fernandobeckman/ponte-de-palito-/docs/img/manual/p30.jpg

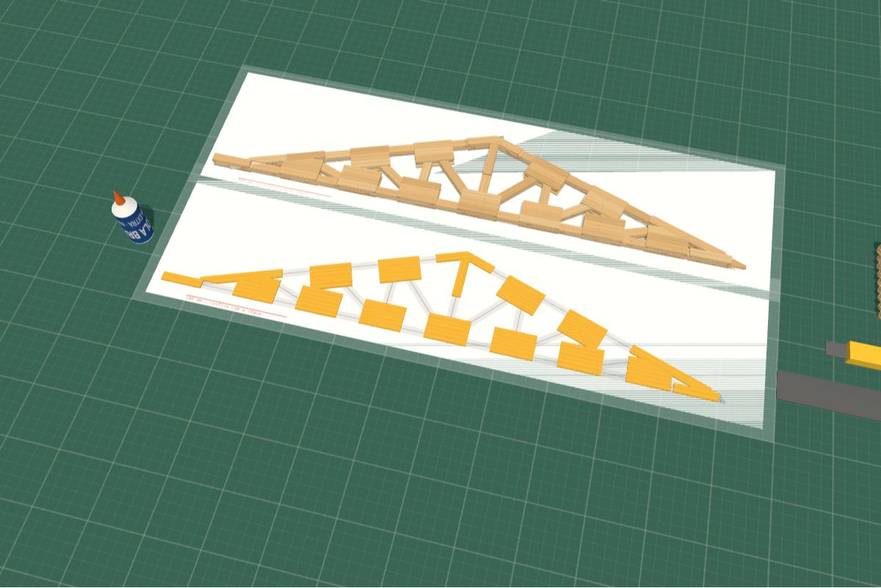
docs/img/manual/p30.jpg
