fernandobeckman/ponte-de-palito-/docs/img/manual/p22.jpg

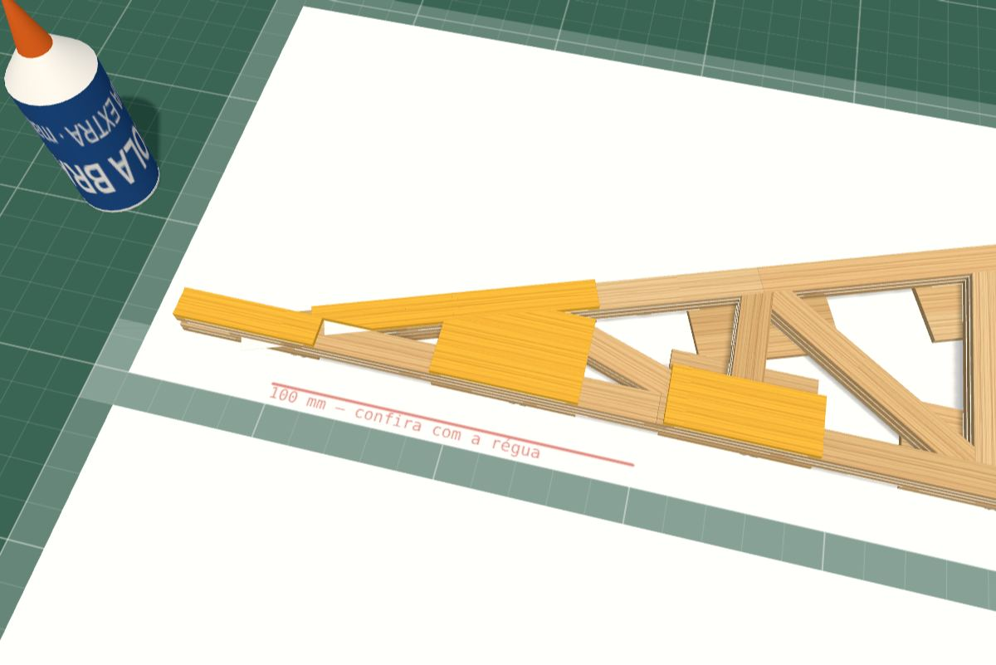
docs/img/manual/p22.jpg
