fernandobeckman/ponte-de-palito-/ERROS.md

# Registro de erros (ler antes de cada tarefa)

Erros já cometidos neste projeto, por Claude ou pela equipe, e a regra para não repeti-los.
Entradas novas vão **no topo**. Veja a skill `.claude/skills/registro-de-erros`.

| # | data | contexto | erro | causa | como evitar |
|---|---|---|---|---|---|
| 30 | 2026-11-09 | Publicação na Netlify | A Netlify recusou um novo deploy: "Account credit usage exceeded". O plano grátis tem créditos por mês, cada publicação gasta créditos, e a conta tem outros sites. Além disso, o script `publicar_netlify.sh` não mostrava o erro (imprimiu "None None") | Publiquei várias vezes seguidas, a cada ajuste pequeno, e o script engolia o erro | Juntar as mudanças e publicar na Netlify só no fim. O GitHub Pages continua como espelho, sem limite. O script agora para e mostra o erro da Netlify. |
| 29 | 2026-11-09 | Navegação 3D sem limites | A câmera podia passar para baixo da mesa (tela vazia, porque a mesa só aparece de cima) e se afastar até perder a cena. A vista "Baixo" levava para baixo da mesa | Dei liberdade total sem colocar barreiras | Toda cena 3D tem chão (câmera acima da mesa), caixa-limite para a câmera e para o ponto de foco, e distância máxima. Afastar o zoom não move o ponto de foco. |
| 28 | 2026-11-09 | Chave da Netlify | A primeira chave foi recusada (401, provavelmente copiada incompleta) e depois uma chave foi colada no chat | Não expliquei de início que a chave vai só no formulário seguro e que o código deve ser copiado pelo botão de copiar | Pedir chaves sempre pelo formulário seguro, nunca no chat. Se uma chave aparecer no chat, não usar e pedir para apagá-la e criar outra. |
| 27 | 2026-11-09 | Publicação no GitHub Pages | O campo "Domínio personalizado" foi preenchido com `fernando.beckman`. O GitHub criou `docs/CNAME` e passou a redirecionar para um domínio que não existe. Depois de remover, o celular continuou indo para o endereço antigo por cache | Nas instruções não avisei para deixar esse campo vazio | Ao orientar a ativação do Pages, avisar explicitamente: "Domínio personalizado fica vazio". Para testar depois de mudar o domínio, usar aba anônima. Conferir o status da publicação pela API de deployments (`environment_url`). |
| 26 | 2026-11-09 | Manual de corte | Primeira versão: (1) a folga visual de 0,3 mm entre peças entrava na medida de corte (99,7 mm em vez de 100 mm) e dividia peças iguais em códigos diferentes; (2) os ângulos saíam do contorno arredondado (19,0° em vez de 19,8°); (3) havia uma chapa triangular de 12,8 mm impossível de cortar | Efeito visual misturado com geometria real; arredondamento usado para medir, e não só para agrupar | Geometria de corte nunca leva folga visual. Arredondar só para agrupar tipos; medidas e ângulos saem da geometria exata e são conferidos com a inclinação conhecida (19,8°, 39,6°, 70,2°). Peças menores que 80 mm² são eliminadas. |
| 25 | 2026-11-09 | Navegação do 3D | O usuário achou o 3D "muito ruim para navegar": só girava, o zoom ia sempre para o centro, não havia pan e a câmera "Seguir o passo" puxava a vista de volta | Fiz um controle mínimo e liguei o seguir sem deixar o usuário no comando | Toda vista 3D precisa de: girar, mover (2 dedos ou botão direito), zoom na direção do dedo ou cursor, toque duplo para aproximar, modo para andar por dentro, vistas prontas e tela ampliada. Câmera automática desliga quando o usuário mexe. |
| 24 | 2026-11-09 | Espaçadores provisórios | Usei blocos genéricos ("madeira, caixinha, papelão"), mas o usuário definiu que a ponte é só palito de picolé e cola branca | Achei que peça provisória não precisava seguir a regra de material | Todo item que encosta na ponte, até o provisório, segue a regra de material do usuário. Agora os espaçadores são de palito (4 camadas × 2 palitos de 74 mm). Antes de propor qualquer peça, conferir em `docs/requisitos.md` ou no histórico. |
| 23 | 2026-11-09 | Espaçadores na animação | A legenda dizia 74 mm, mas o 3D desenhava blocos de 70 mm, encostados nas chapas e marrons como madeira. O usuário achou que faziam parte da ponte | Desenhei o bloco sem conferir com o texto, e peça provisória ficou parecendo peça definitiva | Peça provisória precisa de visual diferente (listrada, escrito "PROVISÓRIO") e de legenda dizendo que sai depois. A medida do 3D tem que ser a mesma do texto. |
| 22 | 2026-11-09 | 3D no celular (app do Claude, Android) | A montagem mostrou "Não foi possível carregar o 3D". O Three.js era carregado por *import map* (`import("three")`), e o OrbitControls também dependia dele. Causa provável: dentro do app a página é embrulhada pela plataforma, e navegadores Android mais antigos ignoram um *import map* que aparece depois de outro módulo já carregado | Testei só com a página sozinha, num Chromium recente, e não no ambiente real | Não usar *import map* em artifacts. Importar pelo endereço completo, com CDN de reserva (jsDelivr, depois unpkg), e usar controles próprios, sem módulos que importem `"three"`. Toda página 3D precisa ter modo texto caso o 3D falhe. Pedir ao usuário que teste no celular logo após publicar. |
| 21 | 2026-11-09 | Memorial v2 | Escrevi a resistência da diagonal central como 1296,13500 N; o valor calculado é 1296,10495 N | Digitei o número em vez de copiar da saída do script | Copiar todo número do memorial da saída de `calculo_ponte.py` (`projeto/saida_calculo.txt`), nunca digitar de memória. |
| 20 | 2026-11-09 | Página de montagem | O selo "24 h" e o texto "Carregando" apareciam o tempo todo: o `display: grid` do meu CSS anulava o atributo `hidden` | Contei com o reset da plataforma, que não existe no teste local | Todo CSS de página leva `[hidden] { display: none !important; }`. |
| 19 | 2026-11-09 | Chapas de ligação (v1) | Uma faixa de chapa (8,4 mm) cobria menos que os 13,42 mm de sobreposição exigidos pelo cálculo | O cálculo dizia "adote 20 mm", mas não conferi se a chapa desenhada tinha esse tamanho | Conferir cada dimensão do cálculo no modelo físico (`gerar_montagem.py`). Agora são 2 faixas, ou 16,8 mm. |
| 18 | 2026-11-09 | Transversina central (v1) | O memorial mandava apoiar a transversina "em cima do banzo inferior", mas ali passam o montante e duas diagonais do nó b4 | Detalhei a peça só no cálculo, sem desenhar a geometria | Detalhe construtivo só vale depois de modelado em 3D sem colisão. Agora ela fica sobre consolos. |
| 17 | 2026-11-09 | Camadas (v1) | Alma com 2 camadas (4 mm) e banzos com 3 (6 mm): as chapas das duas faces não ficariam planas | Dimensionei cada barra isoladamente, sem pensar na montagem | Barras que se encontram numa chapa precisam ter a mesma espessura. Agora todas têm 3 camadas. |
| 16 | 2026-11-09 | Pesquisa de preços e ficha técnica | `datasheets.tdx.henkel.com` foi bloqueado pela rede da sessão | Rede restrita | Usar o resumo da busca, citar a ficha técnica como fonte e marcar como estimativa o que não tiver preço publicado. |
| 15 | 2026-11-09 | Git | Fiz o commit sem verificar o resultado do `git checkout main`, que tinha falhado, e o commit caiu em outra branch. Também ficou um `.pyc` versionado | Encadeei comandos com `;` em vez de `&&`, e o repositório não tinha `.gitignore` | Encadear comandos git com `&&` e conferir `git status -sb` antes de cada commit. O `.gitignore` agora ignora `__pycache__`. |
| 14 | 2026-11-09 | Memorial: peso próprio | Escrevi "0,07% da carga"; o valor certo é 0,69% (0,309 kg ÷ 45 kg) | Fiz a porcentagem de cabeça | Toda porcentagem do memorial deve ser calculada no script ou conferida com a divisão escrita ao lado. |
| 13 | 2026-11-09 | Detalhamento das ligações | Calculei as chapas nó a nó para os banzos: 30 mm de sobreposição em cada ponta de barras de 62,5 mm, ou seja, chapa cobrindo quase a barra inteira | Dimensionei as ligações sem pensar em como a peça é montada | Verificar se a ligação cabe fisicamente. Banzos retos devem ser feitos contínuos e laminados, com emendas desencontradas. |
| 12 | 2026-11-09 | Estudo de geometrias | O primeiro estudo considerou só a carga exatamente no centro. Nele, o Parker tinha diagonais "nulas" com 2 camadas, mas com a carga deslocada um painel o FS caía para 1,21 | Hipótese de carregamento ideal demais | Dimensionar sempre por envoltória: carga no centro (FS 2,0) e deslocada ±1 painel (FS 1,5). |
| 11 | 2026-11-09 | Precisão numérica | O solver `trelica.py` arredondava N para 3 casas e L para 2, mas o usuário pediu 5 casas | Arredondamento fixo no código | O solver agora guarda 6 casas e imprime 5. Formatar na saída, nunca arredondar os dados internos. |
| 10 | 2026-11-09 | Pesquisa de material | Os sites periodicos.ufsm.br e blogspot estão bloqueados na rede da sessão | Rede restrita do ambiente | Se um host falhar com ENOTFOUND, não insistir em outros do mesmo tipo. Usar o resumo da busca, citar a fonte secundária e marcar [PENDENTE] para confirmação. |
| 9 | 2026-11-09 | Push de branch nova a partir de um clone raso | O push funcionou, mas `origin/<branch>` não apareceu no clone e o hook disse que havia commit não enviado | O clone raso (`--depth 1`) só busca a branch `main`, então o push não cria a referência remota local | Depois de enviar uma branch nova, rodar `git fetch origin +refs/heads/<branch>:refs/remotes/origin/<branch>` e conferir com `git status -sb`. |
| 8 | 2026-11-09 | Teste da página 3D no Chromium headless | O Three.js do CDN (unpkg) não carregou (`ERR_TUNNEL_CONNECTION_FAILED`) | O Chromium da sessão na nuvem não passa pelo proxy para CDNs | Para testar, instalar a mesma versão com `npm i three@0.160.0` e interceptar as URLs do CDN com `page.route` para os arquivos locais. Fixar sempre a versão exata. |
| 7 | 2026-11-09 | Skill `openscad-ponte` (json2scad.py) | Rotação das barras escrita com sinais negativos: `rotate([0,-acos(..),-atan2(..)])`, o que apontaria as barras na direção errada | Escrevi a fórmula de memória sem conferir | Conferir toda transformação geométrica numericamente: o vetor (0,0,1) rotacionado tem de bater com d/L. A forma correta é `rotate([0, acos(dz/L), atan2(dy,dx)])`. |
| 6 | 2026-11-09 | Seleção de skills | Quase incluí `doc-coauthoring` (Anthropic) e a skill OpenSCAD de andreahaku, mas elas **não têm arquivo de licença** | Supus que repositório público = livre para copiar | Antes de copiar, verificar o arquivo LICENSE de **cada** skill/agente. Sem licença → só citar como referência, não copiar. |
| 5 | 2026-11-09 | Agentes da VoltAgent | 3 agentes (`scientific-literature-researcher`, `ui-ux-tester`, `visual-asset-generator`) citam ferramentas MCP que não estão instaladas | Os agentes vieram de outro ambiente | Antes de usar um agente, ver a linha `tools:`. Se citar `mcp__...` ou `chrome-mcp`, instalar o MCP ou esperar só funcionamento parcial. |
| 4 | 2026-11-09 | Shell | Usei `cd` para dentro de pastas e o diretório de trabalho da sessão mudou junto | O `cd` persiste entre os comandos | Usar sempre caminhos absolutos nos comandos e não depender de `cd`. |
| 3 | 2026-11-09 | Ver estrelas de repositórios | `curl api.github.com/repos/...` foi bloqueado para repositórios não anexados à sessão | O proxy só libera a API do GitHub para repositórios anexados | Para metadados públicos (estrelas e licença), usar WebFetch na página do GitHub. Para o código, usar `git clone --depth 1`. |
| 2 | 2026-11-09 | Criar um repositório no GitHub | `gh auth status` mostrou que o token `GH_TOKEN` é inválido, então não dá para criar repositório pelo `gh` | A sessão na nuvem não tem um token pessoal válido | Criar repositório só pelo site (github.com/new). Para anexar um repositório que já existe, usar a ferramenta `add_repo`. |
| 1 | 2026-11-09 | Cálculo da treliça | (prevenção) Um resultado de solver pode estar errado sem dar nenhum aviso | — | Sempre conferir o equilíbrio (deve dar ≈0) e checar uma barra à mão pelo método das seções antes de reportar. |
