fernandobeckman/ponte-de-palito-/docs/img/capa.jpg

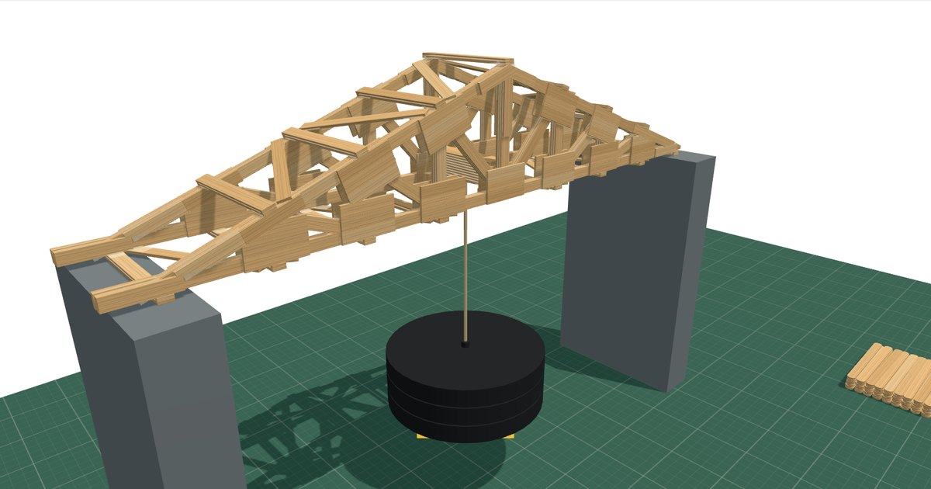
docs/img/capa.jpg
