fernandobeckman/ponte-de-palito-/docs/img/passo_corte.jpg

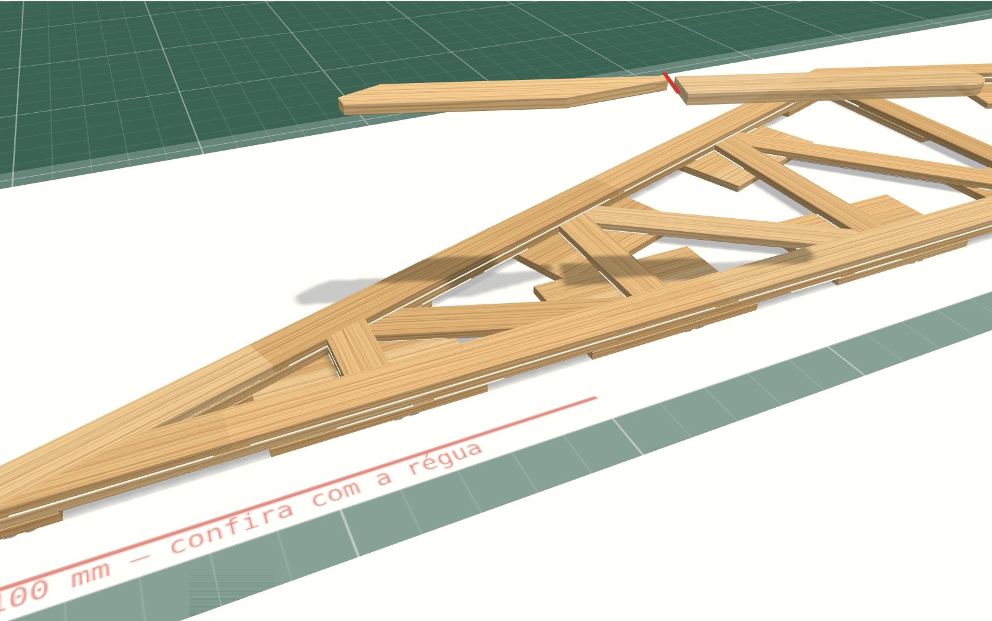
docs/img/passo_corte.jpg
