fernandobeckman/ponte-de-palito-/docs/img/passo_levantar.jpg

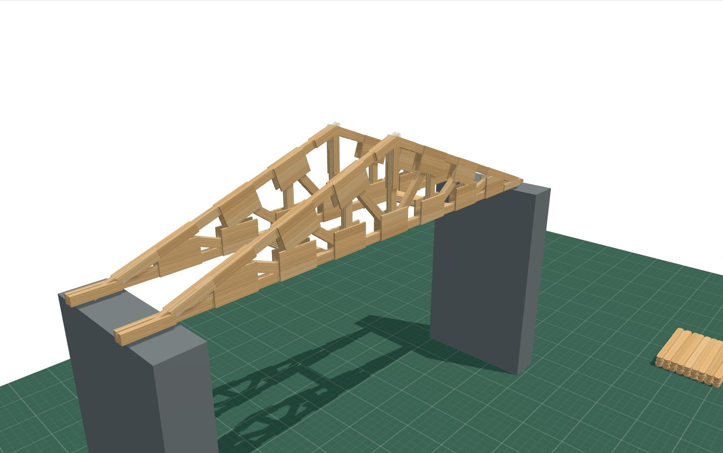
docs/img/passo_levantar.jpg
