fernandobeckman/ponte-de-palito-/docs/img/passo_trelica.jpg

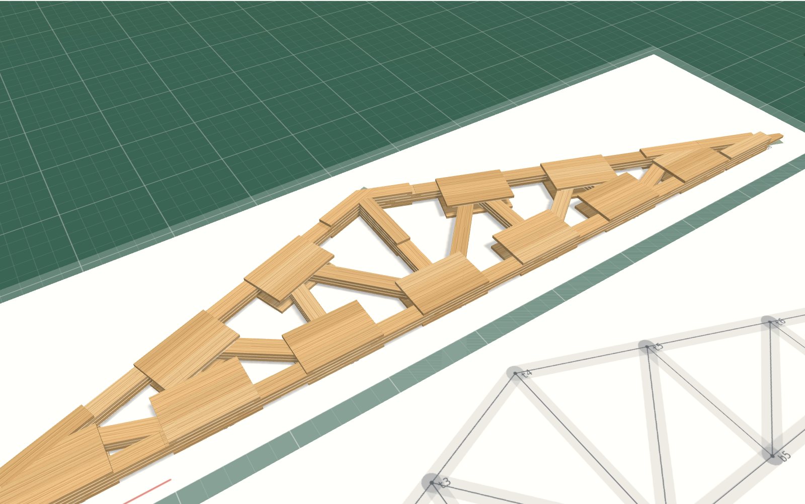
docs/img/passo_trelica.jpg
