fernandobeckman/ponte-de-palito-/docs/img/por_dentro.jpg

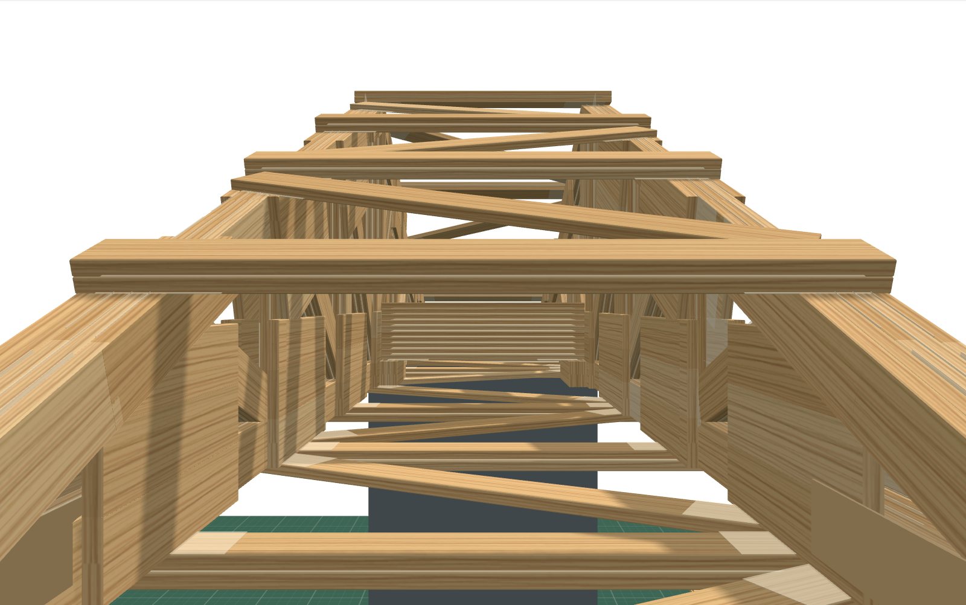
docs/img/por_dentro.jpg
