fernandobeckman/ponte-de-palito-/projeto/ponte-3d.png

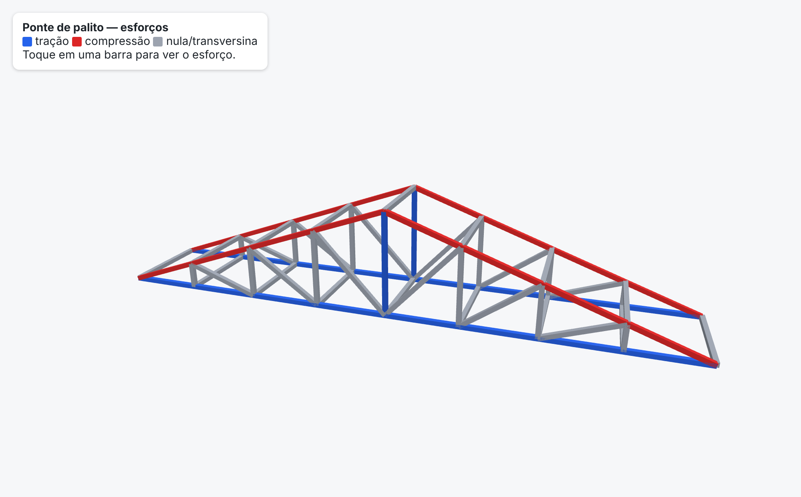
projeto/ponte-3d.png
