fernandobeckman/ponte-de-palito-/modelos/ponte_parker_8x90.scad

// gerado por json2scad.py — seção 8.4 x 4.0 mm
b=8.4; h=4.0;
module barra(p1,p2){ d=p2-p1; L=norm(d);
  translate(p1) rotate([0,acos(d[2]/L),atan2(d[1],d[0])])
  translate([-b/2,-h/2,0]) cube([b,h,L]); }
barra([0.0, 0.0, 0.0],[62.5, 0.0, 0.0]);
barra([62.5, 0.0, 0.0],[125.0, 0.0, 0.0]);
barra([125.0, 0.0, 0.0],[187.5, 0.0, 0.0]);
barra([187.5, 0.0, 0.0],[250.0, 0.0, 0.0]);
barra([250.0, 0.0, 0.0],[312.5, 0.0, 0.0]);
barra([312.5, 0.0, 0.0],[375.0, 0.0, 0.0]);
barra([375.0, 0.0, 0.0],[437.5, 0.0, 0.0]);
barra([437.5, 0.0, 0.0],[500.0, 0.0, 0.0]);
barra([62.5, 22.5, 0.0],[125.0, 45.0, 0.0]);
barra([125.0, 45.0, 0.0],[187.5, 67.5, 0.0]);
barra([187.5, 67.5, 0.0],[250.0, 90.0, 0.0]);
barra([250.0, 90.0, 0.0],[312.5, 67.5, 0.0]);
barra([312.5, 67.5, 0.0],[375.0, 45.0, 0.0]);
barra([375.0, 45.0, 0.0],[437.5, 22.5, 0.0]);
barra([0.0, 0.0, 0.0],[62.5, 22.5, 0.0]);
barra([437.5, 22.5, 0.0],[500.0, 0.0, 0.0]);
barra([62.5, 0.0, 0.0],[62.5, 22.5, 0.0]);
barra([125.0, 0.0, 0.0],[125.0, 45.0, 0.0]);
barra([187.5, 0.0, 0.0],[187.5, 67.5, 0.0]);
barra([250.0, 0.0, 0.0],[250.0, 90.0, 0.0]);
barra([312.5, 0.0, 0.0],[312.5, 67.5, 0.0]);
barra([375.0, 0.0, 0.0],[375.0, 45.0, 0.0]);
barra([437.5, 0.0, 0.0],[437.5, 22.5, 0.0]);
barra([62.5, 22.5, 0.0],[125.0, 0.0, 0.0]);
barra([125.0, 45.0, 0.0],[187.5, 0.0, 0.0]);
barra([187.5, 67.5, 0.0],[250.0, 0.0, 0.0]);
barra([312.5, 67.5, 0.0],[250.0, 0.0, 0.0]);
barra([375.0, 45.0, 0.0],[312.5, 0.0, 0.0]);
barra([437.5, 22.5, 0.0],[375.0, 0.0, 0.0]);
barra([0.0, 0.0, 80.0],[62.5, 0.0, 80.0]);
barra([62.5, 0.0, 80.0],[125.0, 0.0, 80.0]);
barra([125.0, 0.0, 80.0],[187.5, 0.0, 80.0]);
barra([187.5, 0.0, 80.0],[250.0, 0.0, 80.0]);
barra([250.0, 0.0, 80.0],[312.5, 0.0, 80.0]);
barra([312.5, 0.0, 80.0],[375.0, 0.0, 80.0]);
barra([375.0, 0.0, 80.0],[437.5, 0.0, 80.0]);
barra([437.5, 0.0, 80.0],[500.0, 0.0, 80.0]);
barra([62.5, 22.5, 80.0],[125.0, 45.0, 80.0]);
barra([125.0, 45.0, 80.0],[187.5, 67.5, 80.0]);
barra([187.5, 67.5, 80.0],[250.0, 90.0, 80.0]);
barra([250.0, 90.0, 80.0],[312.5, 67.5, 80.0]);
barra([312.5, 67.5, 80.0],[375.0, 45.0, 80.0]);
barra([375.0, 45.0, 80.0],[437.5, 22.5, 80.0]);
barra([0.0, 0.0, 80.0],[62.5, 22.5, 80.0]);
barra([437.5, 22.5, 80.0],[500.0, 0.0, 80.0]);
barra([62.5, 0.0, 80.0],[62.5, 22.5, 80.0]);
barra([125.0, 0.0, 80.0],[125.0, 45.0, 80.0]);
barra([187.5, 0.0, 80.0],[187.5, 67.5, 80.0]);
barra([250.0, 0.0, 80.0],[250.0, 90.0, 80.0]);
barra([312.5, 0.0, 80.0],[312.5, 67.5, 80.0]);
barra([375.0, 0.0, 80.0],[375.0, 45.0, 80.0]);
barra([437.5, 0.0, 80.0],[437.5, 22.5, 80.0]);
barra([62.5, 22.5, 80.0],[125.0, 0.0, 80.0]);
barra([125.0, 45.0, 80.0],[187.5, 0.0, 80.0]);
barra([187.5, 67.5, 80.0],[250.0, 0.0, 80.0]);
barra([312.5, 67.5, 80.0],[250.0, 0.0, 80.0]);
barra([375.0, 45.0, 80.0],[312.5, 0.0, 80.0]);
barra([437.5, 22.5, 80.0],[375.0, 0.0, 80.0]);
barra([0.0, 0.0, 0.0],[0.0, 0.0, 80.0]);
barra([62.5, 0.0, 0.0],[62.5, 0.0, 80.0]);
barra([125.0, 0.0, 0.0],[125.0, 0.0, 80.0]);
barra([187.5, 0.0, 0.0],[187.5, 0.0, 80.0]);
barra([250.0, 0.0, 0.0],[250.0, 0.0, 80.0]);
barra([312.5, 0.0, 0.0],[312.5, 0.0, 80.0]);
barra([375.0, 0.0, 0.0],[375.0, 0.0, 80.0]);
barra([437.5, 0.0, 0.0],[437.5, 0.0, 80.0]);
barra([500.0, 0.0, 0.0],[500.0, 0.0, 80.0]);
barra([62.5, 22.5, 0.0],[62.5, 22.5, 80.0]);
barra([125.0, 45.0, 0.0],[125.0, 45.0, 80.0]);
barra([187.5, 67.5, 0.0],[187.5, 67.5, 80.0]);
barra([250.0, 90.0, 0.0],[250.0, 90.0, 80.0]);
barra([312.5, 67.5, 0.0],[312.5, 67.5, 80.0]);
barra([375.0, 45.0, 0.0],[375.0, 45.0, 80.0]);
barra([437.5, 22.5, 0.0],[437.5, 22.5, 80.0]);
