fernandobeckman/ponte-de-palito-/docs/manual_de_corte.pdf

Manual de corte — como usar | Ponte Parker 8×90 · manual de corte · página 1

### Cada formato de peça tem um CÓDIGO

letra da família + número (ex.: B1 = banzo de 100 mm com cortes retos).

### Cada peça da ponte tem um NÚMERO

### de 1 a 412, na ordem de montagem. Escreva o número a lápis na peça logo depois de

cortar.
Moldes em tamanho real | imprima em 100% (sem ajustar à página) e confira a régua de 100 mm. Apoie o palito
sobre o molde e corte nas linhas.
Ângulo do corte | medido entre a linha de corte e a borda comprida do palito. 90° = corte reto. 'Em bico' =
ponta com dois cortes.
Borda A e borda B | comprimento de cada lado comprido depois de cortado. Marque as duas medidas e
ligue os pontos com a régua.
Palito | 8,4 mm × 2,0 mm × 110 mm; parte reta útil de 101,6 mm (sem as pontas
arredondadas).
Peças iguais | têm o mesmo código: corte todas de uma vez, separe em montinhos por código (como
os saquinhos do LEGO).

## Famílias de peças

B Banzo | 16 tipo(s), 80 peça(s)
D Diagonal | 3 tipo(s), 36 peça(s)
M Montante | 4 tipo(s), 42 peça(s)
C Chapa de ligação | 8 tipo(s), 168 peça(s)
T Transversina | 2 tipo(s), 36 peça(s)
E Escora superior | 1 tipo(s), 14 peça(s)
X Diagonal de contraventamento | 1 tipo(s), 14 peça(s)
K Consolo | 1 tipo(s), 6 peça(s)
P Espaçador provisório | 1 tipo(s), 16 peça(s) — provisório, não fica na ponte

Total: 412 peças em 37 tipos. Dica: corte primeiro os tipos com mais peças (C6, B1, T2...).

Régua de conferência: esta linha deve medir exatamente 100 mm. Se não medir, imprima em 100% (tamanho real).

Moldes em tamanho real (1:1) | Ponte Parker 8×90 · manual de corte · página 2

B1 × 44

Banzo · comprimento total 100,0 mm
Borda A 100,0 mm · borda B 100,0 mm
Pontas: reta (90°) | reta (90°)
Nº 43, 45–47, 50–52, 70–71, 73, 76–79, 97–100, 102, 104–106, 206, 208–210, 213–215, …

B1

100,0 mm

B2 × 4

Banzo · comprimento total 99,3 mm Borda A 99,3 mm · borda B 75,9 mm
Pontas: reta (90°) | inclinada a 19,8°
Nº 44, 53, 207, 216

B2

99,3 mm

B3 × 2

Banzo · comprimento total 96,7 mm Borda A 96,7 mm · borda B 96,7 mm
Pontas: reta (90°) | reta (90°)
Nº 107, 270

B3

96,7 mm

B4 × 2

Banzo · comprimento total 92,0 mm Borda A 92,0 mm · borda B 92,0 mm
Pontas: reta (90°) | reta (90°)
Nº 72, 235

B4

92,0 mm

B5 × 2

Banzo · comprimento total 77,4 mm Borda A 77,4 mm · borda B 67,2 mm
Pontas: reta (90°) | inclinada a 39,6°
Nº 48, 211

B5

77,4 mm

B6 × 4

Banzo · comprimento total 64,3 mm Borda A 63,2 mm · borda B 49,5 mm
Pontas: reta (90°) | em bico: 70,2° e 19,8°
Nº 68, 81, 231, 244

B6

64,3 mm

B7 × 2

Banzo · comprimento total 64,2 mm Borda A 64,2 mm · borda B 54,0 mm
Pontas: reta (90°) | inclinada a 39,6°
Nº 49, 212

B7

64,2 mm

B8 × 2

Banzo · comprimento total 62,6 mm Borda A 62,6 mm · borda B 39,3 mm
Pontas: reta (90°) | inclinada a 19,8°
Nº 80, 243

B8

62,6 mm

B9 × 2

Banzo · comprimento total 44,0 mm Borda A 44,0 mm · borda B 33,9 mm
Pontas: reta (90°) | inclinada a 39,6°
Nº 101, 264

B9

44,0 mm

Régua de conferência: esta linha deve medir exatamente 100 mm. Se não medir, imprima em 100% (tamanho real).

Moldes em tamanho real (1:1) | Ponte Parker 8×90 · manual de corte · página 3

B10 × 2

Banzo · comprimento total 35,9 mm
Borda A 35,9 mm · borda B 12,6 mm
Pontas: reta (90°) | inclinada a 19,8°
Nº 69, 232

B10

35,9 mm

B11 × 2

Banzo · comprimento total 33,3 mm Borda A 33,3 mm · borda B 33,3 mm
Pontas: reta (90°) | reta (90°)
Nº 95, 258

B11

33,3 mm

B12 × 4

Banzo · comprimento total 32,6 mm Borda A 32,6 mm · borda B 9,3 mm
Pontas: reta (90°) | inclinada a 19,8°
Nº 96, 108, 259, 271

B12

32,6 mm

B13 × 2

Banzo · comprimento total 30,9 mm Borda A 30,9 mm · borda B 20,7 mm
Pontas: reta (90°) | inclinada a 39,6°
Nº 103, 266

B13

30,9 mm

B14 × 2

Banzo · comprimento total 30,0 mm Borda A 30,0 mm · borda B 30,0 mm
Pontas: reta (90°) | reta (90°)
Nº 54, 217

B14

30,0 mm

B15 × 2

Banzo · comprimento total 28,6 mm Borda A 28,6 mm · borda B 18,5 mm
Pontas: reta (90°) | inclinada a 39,6°
Nº 75, 238

B15

28,6 mm

B16 × 2

Banzo · comprimento total 23,5 mm Borda A 23,5 mm · borda B 13,3 mm
Pontas: reta (90°) | inclinada a 39,6°
Nº 74, 237

B16

23,5 mm

D1 × 12

Diagonal · comprimento total 81,0 mm
Borda A 74,9 mm · borda B 71,7 mm
Pontas: em bico: 67,0° e 42,8° | em bico: 47,2° e 42,8°
Nº 60, 62, 87, 89, 114, 116, 223, 225, 250, 252, 277, 279

D1

81,0 mm

D2 × 12

Diagonal · comprimento total 66,0 mm
Borda A 60,8 mm · borda B 55,8 mm
Pontas: em bico: 55,6° e 54,2° | em bico: 35,8° e 54,2°
Nº 58, 64, 85, 91, 112, 118, 221, 227, 248, 254, 275, 281

D2

66,0 mm

Moldes em tamanho real (1:1) | Ponte Parker 8×90 · manual de corte · página 4

D3 × 12

Diagonal · comprimento total 56,1 mm
Borda A 48,8 mm · borda B 36,4 mm
Pontas: em bico: 39,6° e 70,2° | em bico: 19,8° e 70,2°
Nº 56, 66, 83, 93, 110, 120, 219, 229, 246, 256, 273, 283

D3

56,1 mm

M1 × 6

Montante · comprimento total 81,3 mm Borda A 79,8 mm · borda B 79,8 mm
Pontas: reta (90°) | em bico: 70,2° e 70,2°
Nº 61, 88, 115, 224, 251, 278

M1

81,3 mm

M2 × 12

Montante · comprimento total 60,3 mm
Borda A 60,3 mm · borda B 57,3 mm
Pontas: reta (90°) | inclinada a 70,2°
Nº 59, 63, 86, 90, 113, 117, 222, 226, 249, 253, 276, 280

M2

60,3 mm

M3 × 12

Montante · comprimento total 37,8 mm
Borda A 37,8 mm · borda B 34,8 mm
Pontas: reta (90°) | inclinada a 70,2°
Nº 57, 65, 84, 92, 111, 119, 220, 228, 247, 255, 274, 282

M3

37,8 mm

M4 × 12

Montante · comprimento total 15,3 mm
Borda A 15,3 mm · borda B 12,3 mm
Pontas: reta (90°) | inclinada a 70,2°
Nº 55, 67, 82, 94, 109, 121, 218, 230, 245, 257, 272, 284

M4

15,3 mm

C1 × 4

Chapa de ligação · comprimento total 41,7 mm Borda A 41,7 mm · borda B 31,5 mm
Pontas: reta (90°) | inclinada a 39,6°
Nº 19, 140, 182, 303

C1

41,7 mm

C2 × 4

Chapa de ligação · comprimento total 41,5 mm Borda A 40,0 mm · borda B 40,0 mm
Pontas: reta (90°) | em bico: 70,2° e 70,2°
Nº 23, 144, 186, 307

C2

41,5 mm

C3 × 8

Chapa de ligação · comprimento total 40,0 mm Borda A 40,0 mm · borda B 23,9 mm
Pontas: reta (90°) | em bico: 90,0° e 19,8°
Nº 2, 41, 123, 162, 165, 204, 286, 325

C3

40,0 mm

C4 × 8

Chapa de ligação · comprimento total 40,0 mm Borda A 40,0 mm · borda B 32,5 mm
Pontas: reta (90°) | em bico: 90,0° e 19,8°
Nº 12, 31, 133, 152, 175, 194, 296, 315

C4

40,0 mm

Moldes em tamanho real (1:1) | Ponte Parker 8×90 · manual de corte · página 5

C5 × 8

Chapa de ligação · comprimento total 40,0 mm
Borda A 40,0 mm · borda B 35,1 mm
Pontas: reta (90°) | em bico: 19,8° e 90,0°
Nº 3, 40, 124, 161, 166, 203, 287, 324

C5

40,0 mm

C6 × 124

Chapa de ligação · comprimento total 40,0 mm
Borda A 40,0 mm · borda B 40,0 mm
Pontas: reta (90°) | reta (90°)
Nº 1, 4–5, 7–11, 13–18, 20–22, 25–30, 32–36, 38–39, 42, 122, 125–126, 128–132, 134–1…

C6

40,0 mm

C7 × 8

Chapa de ligação · comprimento total 35,1 mm Borda A 35,1 mm · borda B 11,8 mm
Pontas: reta (90°) | inclinada a 19,8°
Nº 6, 37, 127, 158, 169, 200, 290, 321

C7

35,1 mm

C8 × 4

Chapa de ligação · comprimento total 28,5 mm Borda A 28,5 mm · borda B 18,3 mm
Pontas: reta (90°) | inclinada a 39,6°
Nº 24, 145, 187, 308

C8

28,5 mm

T1 × 16

Transversina · comprimento total 90,0 mm Borda A 90,0 mm · borda B 90,0 mm
Pontas: reta (90°) | reta (90°)
Nº 343–358

T1

90,0 mm

T2 × 20

Transversina · comprimento total 70,0 mm Borda A 70,0 mm · borda B 70,0 mm
Pontas: reta (90°) | reta (90°)
Nº 393–412

T2

70,0 mm

E1 × 14

Escora superior · comprimento total 90,0 mm Borda A 90,0 mm · borda B 90,0 mm
Pontas: reta (90°) | reta (90°)
Nº 367–380

E1

90,0 mm

X1 × 14

Diagonal de contraventamento · comprimento total 96,6 mm Borda A 96,6 mm · borda B 96,6 mm
Pontas: reta (90°) | reta (90°)
Nº 359–366, 381–386

X1

96,6 mm

K1 × 6

Consolo · comprimento total 30,0 mm Borda A 30,0 mm · borda B 30,0 mm
Pontas: reta (90°) | reta (90°)
Nº 387–392

K1

30,0 mm

Moldes em tamanho real (1:1) | Ponte Parker 8×90 · manual de corte · página 6

P1 × 16

Espaçador provisório · comprimento total 74,0 mm
Borda A 74,0 mm · borda B 74,0 mm
Pontas: reta (90°) | reta (90°)
Nº 327–342

P1

74,0 mm

Índice numerado: número da peça → código | Ponte Parker 8×90 · manual de corte · página 7

Treliça A · chapas da face de baixo

### 1 C6 2 C3 3 C5 4 C6 5 C6 6 C7 7 C6 8 C6 9 C6

### 10 C6 11 C6 12 C4 13 C6 14 C6 15 C6 16 C6 17 C6 18 C6 19 C1 20 C6 21 C6 22 C6 23 C2 24 C8 25 C6 26 C6 27 C6 28 C6 29 C6 30 C6 31 C4 32 C6 33 C6 34 C6 35 C6 36 C6 37 C7 38 C6 39 C6 40 C5 41 C3 42 C6

Treliça A · camada 1

### 43 B1 44 B2 45 B1 46 B1 47 B1 48 B5 49 B7 50 B1 51 B1 52 B1 53 B2

### 54 B14

### 55 M4 56 D3 57 M3 58 D2 59 M2 60 D1 61 M1 62 D1 63 M2 64 D2 65 M3 66 D3 67 M4

Treliça A · camada 2

### 68 B6

### 69 B10

### 70 B1 71 B1 72 B4 73 B1

### 74 B16 75 B15

### 76 B1 77 B1 78 B1 79 B1 80 B8 81 B6 82 M4 83 D3 84 M3 85 D2 86 M2 87 D1 88 M1 89 D1 90 M2 91 D2 92 M3 93 D3 94 M4

Treliça A · camada 3

### 95 B11 96 B12

### 97 B1 98 B1 99 B1

100 B1
101 B9
102 B1
103 B13
104 B1
105 B1
106 B1
107 B3
108 B12
109 M4
110 D3
111 M3
112 D2
113 M2
114 D1
115 M1
116 D1
117 M2
118 D2
119 M3
120 D3
121 M4
Treliça A · chapas da face de cima 122 C6
123 C3
124 C5
125 C6
126 C6
127 C7
128 C6
129 C6
130 C6
131 C6
132 C6
133 C4
134 C6
135 C6
136 C6
137 C6
138 C6
139 C6
140 C1
141 C6
142 C6
143 C6
144 C2
145 C8
146 C6
147 C6
148 C6
149 C6
150 C6
151 C6

152 C4
153 C6
154 C6
155 C6
156 C6
157 C6
158 C7
159 C6
160 C6
161 C5
162 C3
163 C6
Treliça B · chapas da face de baixo 164 C6
165 C3
166 C5
167 C6
168 C6
169 C7
170 C6
171 C6
172 C6
173 C6
174 C6
175 C4
176 C6
177 C6
178 C6
179 C6
180 C6
181 C6
182 C1
183 C6
184 C6
185 C6
186 C2
187 C8
188 C6
189 C6
190 C6
191 C6
192 C6
193 C6
194 C4
195 C6
196 C6
197 C6
198 C6
199 C6
200 C7
201 C6
202 C6
203 C5
204 C3
205 C6
Treliça B · camada 1
206 B1
207 B2
208 B1
209 B1
210 B1
211 B5
212 B7
213 B1
214 B1
215 B1
216 B2
217 B14
218 M4
219 D3
220 M3
221 D2
222 M2
223 D1
224 M1
225 D1
226 M2
227 D2

228 M3
229 D3
230 M4
Treliça B · camada 2
231 B6
232 B10
233 B1
234 B1
235 B4
236 B1
237 B16
238 B15
239 B1
240 B1
241 B1
242 B1
243 B8
244 B6
245 M4
246 D3
247 M3
248 D2
249 M2
250 D1
251 M1
252 D1
253 M2
254 D2
255 M3
256 D3
257 M4
Treliça B · camada 3
258 B11
259 B12
260 B1
261 B1
262 B1
263 B1
264 B9
265 B1
266 B13
267 B1
268 B1
269 B1
270 B3
271 B12
272 M4
273 D3
274 M3
275 D2
276 M2
277 D1
278 M1
279 D1
280 M2
281 D2
282 M3
283 D3
284 M4
Treliça B · chapas da face de cima 285 C6
286 C3
287 C5
288 C6
289 C6
290 C7
291 C6
292 C6
293 C6
294 C6
295 C6
296 C4
297 C6
298 C6
299 C6
300 C6
301 C6
302 C6

Índice numerado (continuação) | Ponte Parker 8×90 · manual de corte · página 8

303 C1
304 C6
305 C6
306 C6
307 C2
308 C8
309 C6
310 C6
311 C6
312 C6
313 C6
314 C6
315 C4
316 C6
317 C6
318 C6
319 C6
320 C6
321 C7
322 C6
323 C6
324 C5
325 C3
326 C6
Espaçadores provisórios
327 P1
328 P1
329 P1
330 P1
331 P1
332 P1
333 P1
334 P1
335 P1
336 P1
337 P1
338 P1
339 P1
340 P1
341 P1
342 P1
Transversinas inferiores
343 T1
344 T1
345 T1
346 T1
347 T1
348 T1
349 T1
350 T1
351 T1
352 T1
353 T1
354 T1
355 T1
356 T1
357 T1
358 T1
Contraventamento inferior
359 X1
360 X1
361 X1
362 X1
363 X1
364 X1
365 X1
366 X1
Escoras superiores
367 E1
368 E1
369 E1
370 E1
371 E1
372 E1
373 E1
374 E1
375 E1
376 E1

377 E1
378 E1
379 E1
380 E1
Contraventamento superior
381 X1
382 X1
383 X1
384 X1
385 X1
386 X1
Transversina central
387 K1
388 K1
389 K1
390 K1
391 K1
392 K1
393 T2
394 T2
395 T2
396 T2
397 T2
398 T2
399 T2
400 T2
401 T2
402 T2
403 T2
404 T2
405 T2
406 T2
407 T2
408 T2
409 T2
410 T2
411 T2
412 T2
