fernandobeckman/ponte-de-palito-/docs/montagem.html

Ponte Parker 8×90 · palito por palito

# Montagem passo a passo

Arraste a barra para a direita e a ponte vai sendo montada: corte de cada palito, o cordão de cola branca, a colagem, a prensagem e a cura. Gire o modelo com o dedo para ver em 360°.

Carregando a bancada 3D…

Passo 1

1 dedo gira · 2 dedos arrastam e dão zoom · toque duplo aproxima · toque numa peça para ver o nome

24 htempo de cura da cola

Tela cheia Sair

Girar em volta Voar por dentro

Seguir o passo Girar 360° Ampliar Números Cores por família Vistas Inteira Lado Frente Cima Baixo Por dentro

Preparação …

B1

cortecolaencaixepressão

Arraste a barra para montar ou desmontar. ▶ mostra o próximo passo inteiro, devagar.

## Números da montagem

Calculado a partir do modelo 3D, peça por peça. A área colada soma todas as faces que recebem cola. O consumo de cola usa 200 g/m², o limite de cima da ficha técnica da Cascorez Extra (160 a 200 g/m²).

## Manual de peças

Como num manual de LEGO: cada formato de peça tem um código (letra da família + número) e cada peça da ponte tem um número, na ordem de montagem. Peças com o mesmo código são iguais: mesmo comprimento e mesmos cortes. Corte todas de uma vez, escreva o número a lápis em cada uma e separe em montinhos por código. Os desenhos abaixo estão na mesma escala entre si. Os moldes em tamanho real estão no manual de corte em PDF.

Ângulo do corte: medido entre a linha de corte e a borda comprida do palito (90° = corte reto). "Em bico" = ponta com dois cortes. Bordas A e B = comprimento de cada lado comprido: marque as duas medidas e ligue os pontos com a régua.

## Lista numerada

Ver as peças de 1 a 412 com código e posição

Nº | Código | Peça | Etapa

## Orçamento

Edite os preços com os valores da sua cidade e marque o que você já tem em casa. O total atualiza na hora.

Já tenho | Item | Qtd. | Preço unit. (R$) | Subtotal
Total a comprar | | | | R$ 0,00

R$ 0,00total a comprar

R$ 0,00se comprar tudo

R$ 0,00custo dos palitos da ponte

Preços de anúncios consultados em novembro de 2026. Itens marcados como estimativa não tinham preço publicado nas fontes consultadas: confira na loja.

Modelo, lista de corte e orçamento gerados por projeto/gerar_montagem.py no repositório fernandobeckman/ponte-de-palito-. Fontes: ficha técnica Cascola Cascorez Extra (Henkel), consumo de 160 a 200 g/m², não adere a polietileno. Preços: palitos (https://escorregaopreco.com.br/ofertas/shopee/5505782), cola PVA (https://www.lojadomecanico.com.br/buscar/cola-pva-preco), estilete e lâminas (https://www.lojadomecanico.com.br/buscar/estilete-de-precisao-para-papel).
