fernandobeckman/ponte-de-palito-/docs/img/manual/p03.jpg

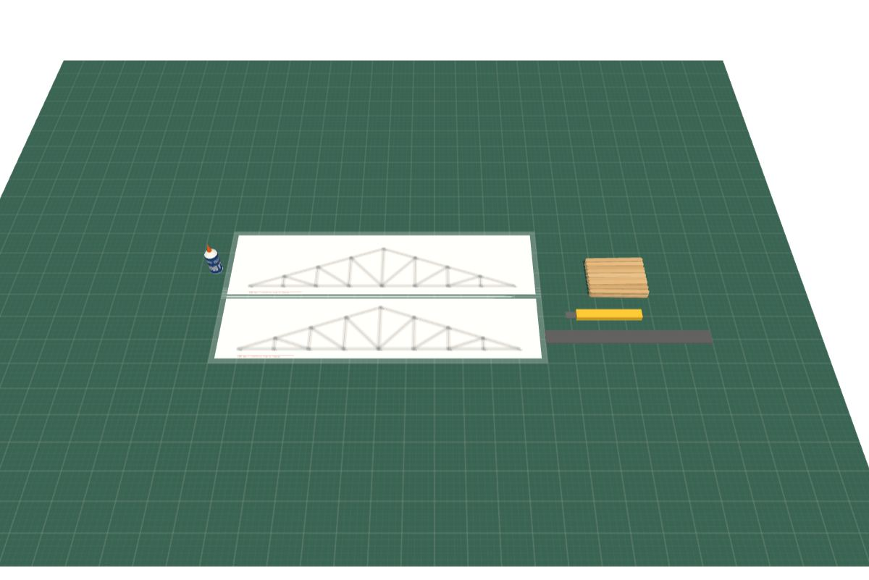
docs/img/manual/p03.jpg
