fernandobeckman/ponte-de-palito-/docs/img/manual/p04.jpg

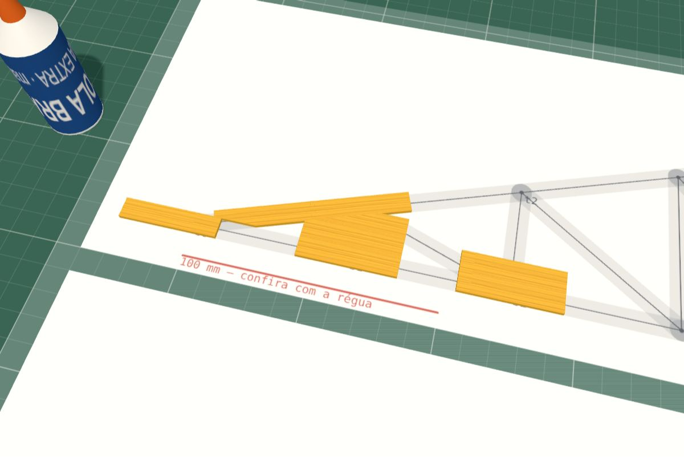
docs/img/manual/p04.jpg
