fernandobeckman/ponte-de-palito-/docs/img/manual/p05.jpg

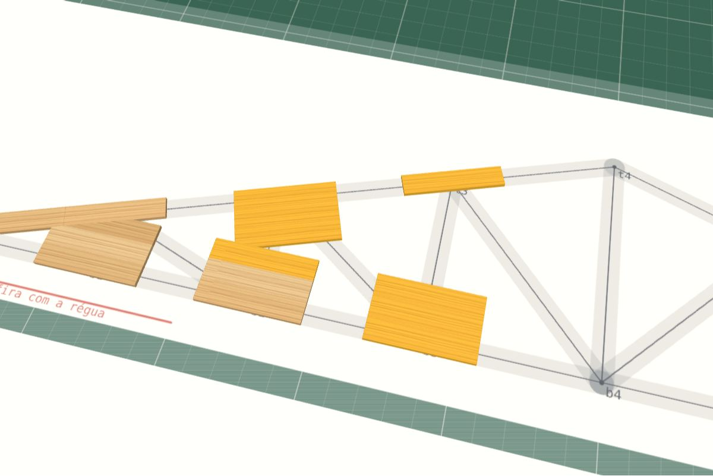
docs/img/manual/p05.jpg
