fernandobeckman/ponte-de-palito-/docs/img/manual/p06.jpg

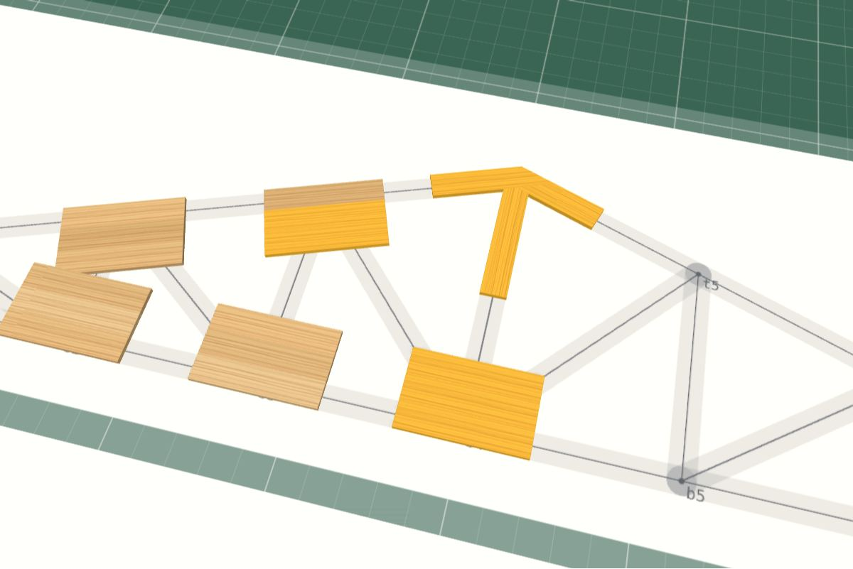
docs/img/manual/p06.jpg
