fernandobeckman/ponte-de-palito-/docs/img/manual/p07.jpg

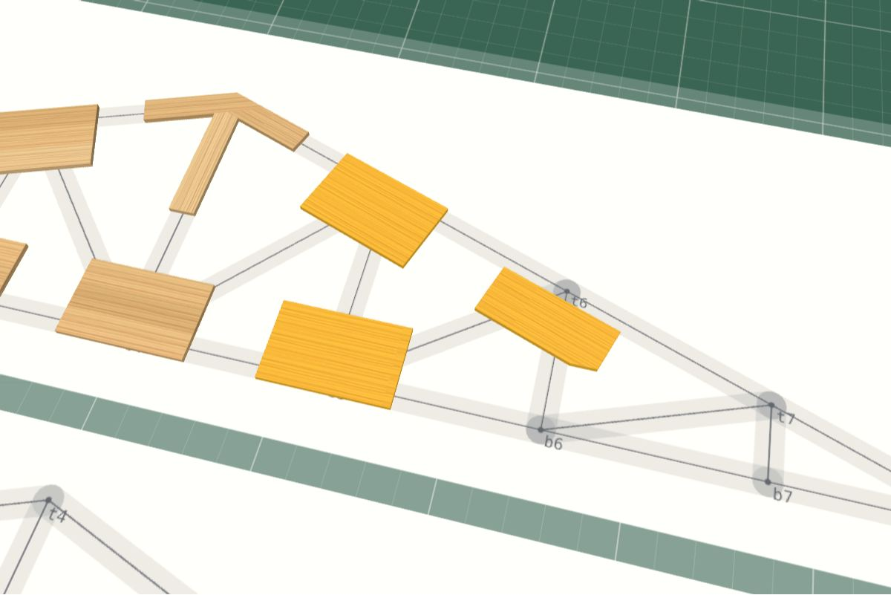
docs/img/manual/p07.jpg
