fernandobeckman/ponte-de-palito-/docs/img/manual/p08.jpg

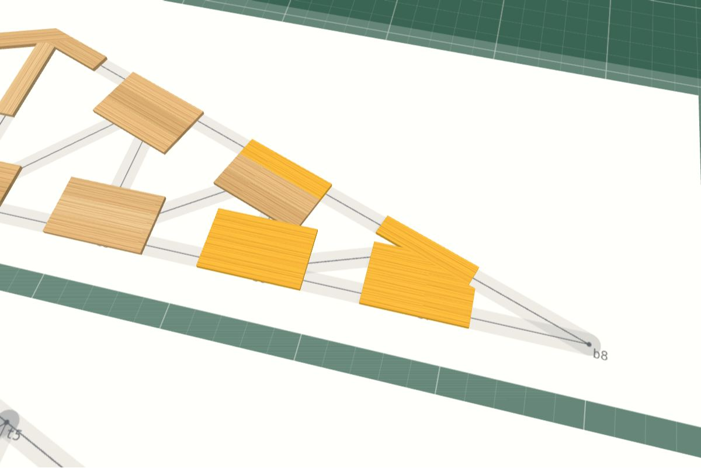
docs/img/manual/p08.jpg
