fernandobeckman/ponte-de-palito-/docs/img/manual/p09.jpg

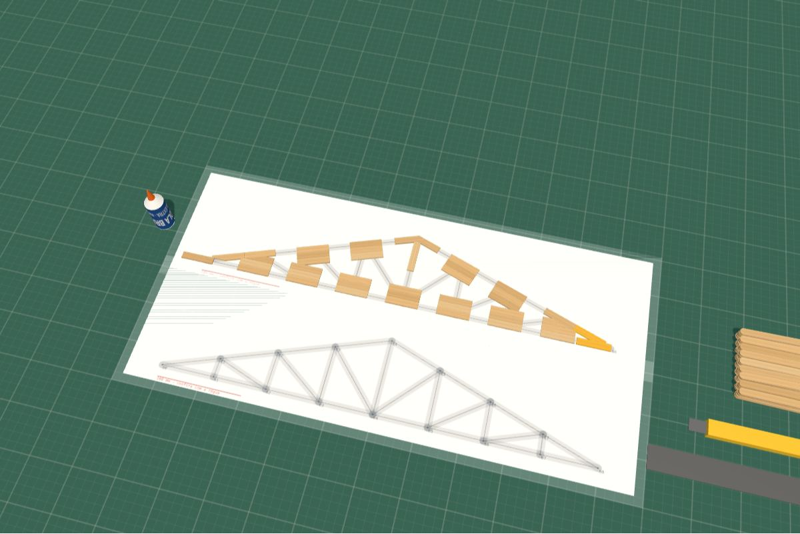
docs/img/manual/p09.jpg
