fernandobeckman/ponte-de-palito-/docs/img/manual/p10.jpg

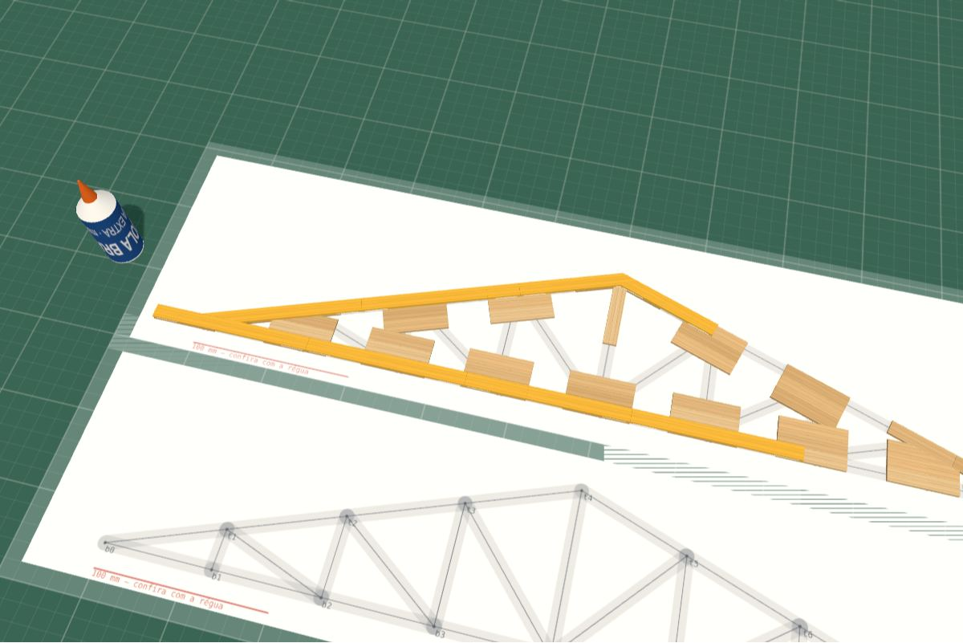
docs/img/manual/p10.jpg
