fernandobeckman/ponte-de-palito-/docs/img/manual/p11.jpg

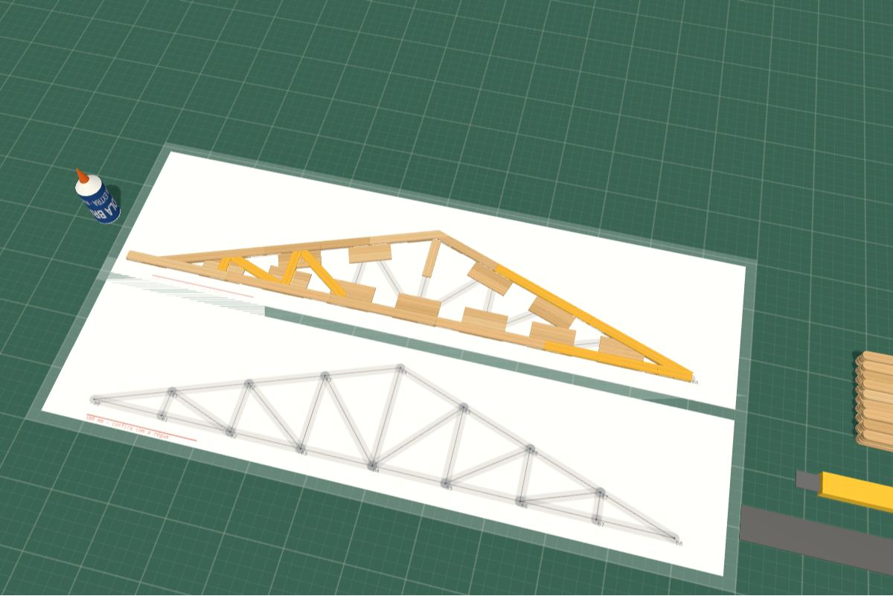
docs/img/manual/p11.jpg
