fernandobeckman/ponte-de-palito-/docs/img/manual/p12.jpg

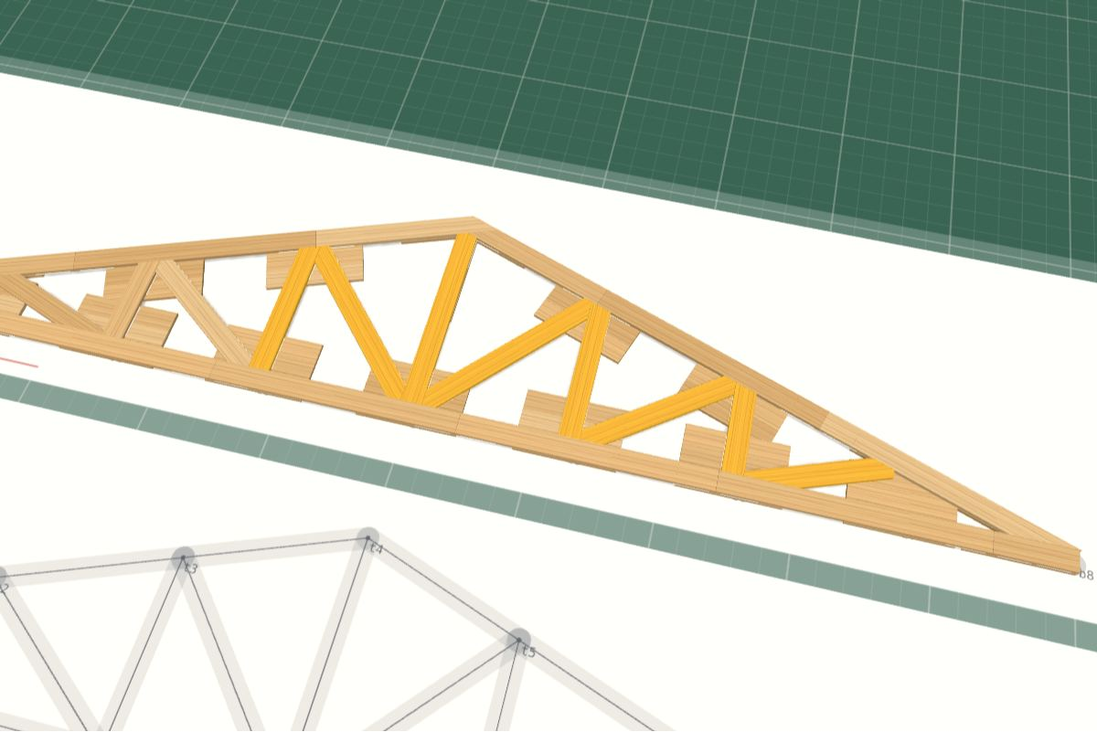
docs/img/manual/p12.jpg
