fernandobeckman/ponte-de-palito-/docs/img/manual/p14.jpg

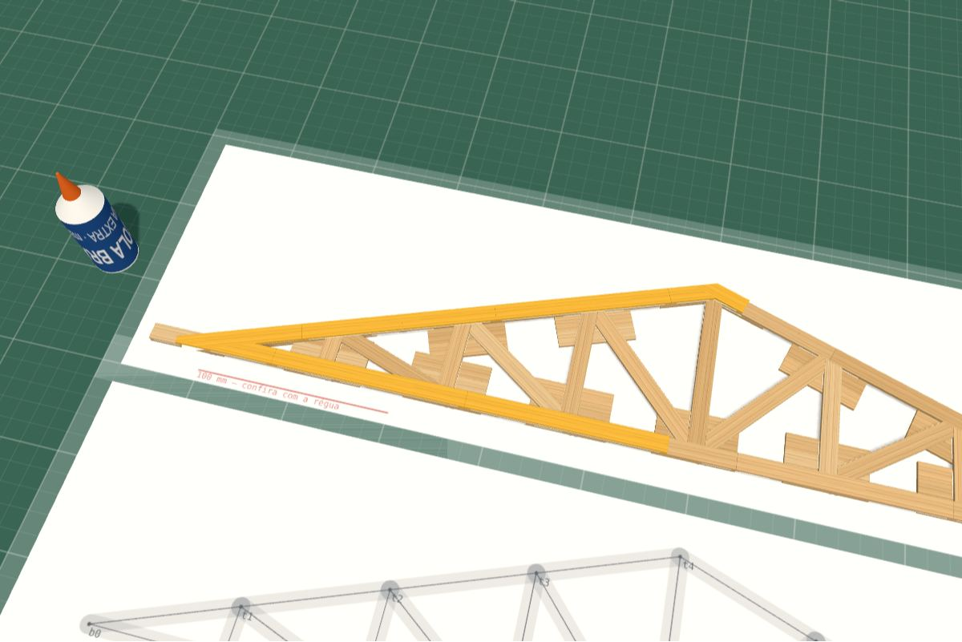
docs/img/manual/p14.jpg
