fernandobeckman/ponte-de-palito-/docs/img/manual/p15.jpg

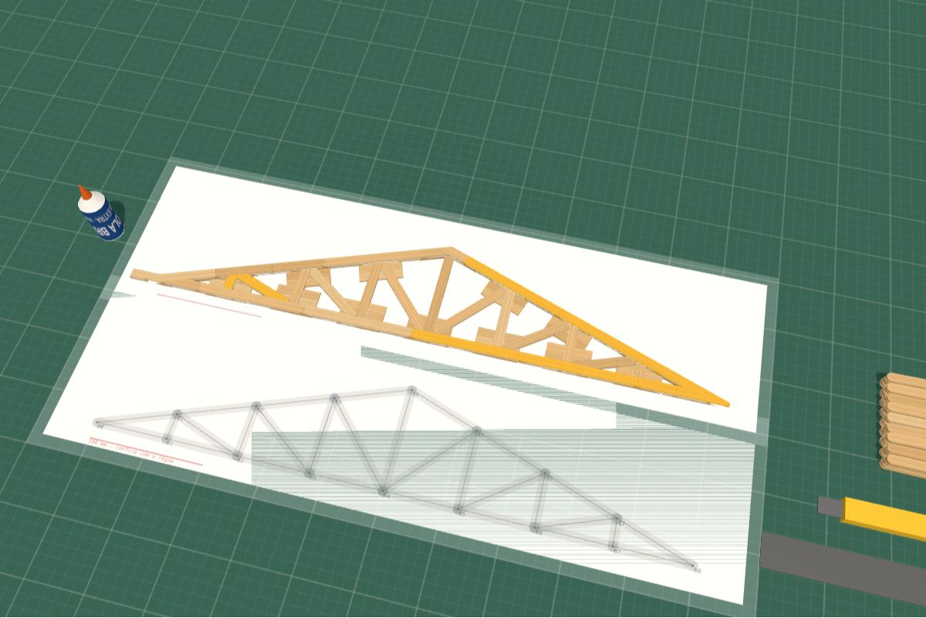
docs/img/manual/p15.jpg
