fernandobeckman/ponte-de-palito-/docs/img/manual/p16.jpg

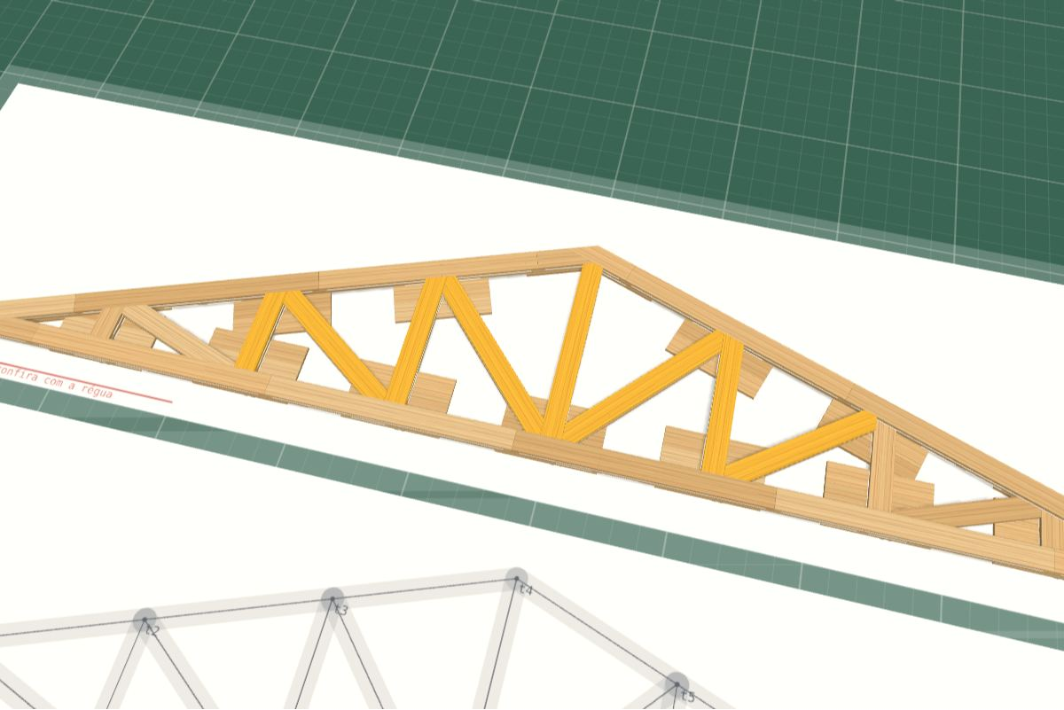
docs/img/manual/p16.jpg
