fernandobeckman/ponte-de-palito-/docs/img/manual/p18.jpg

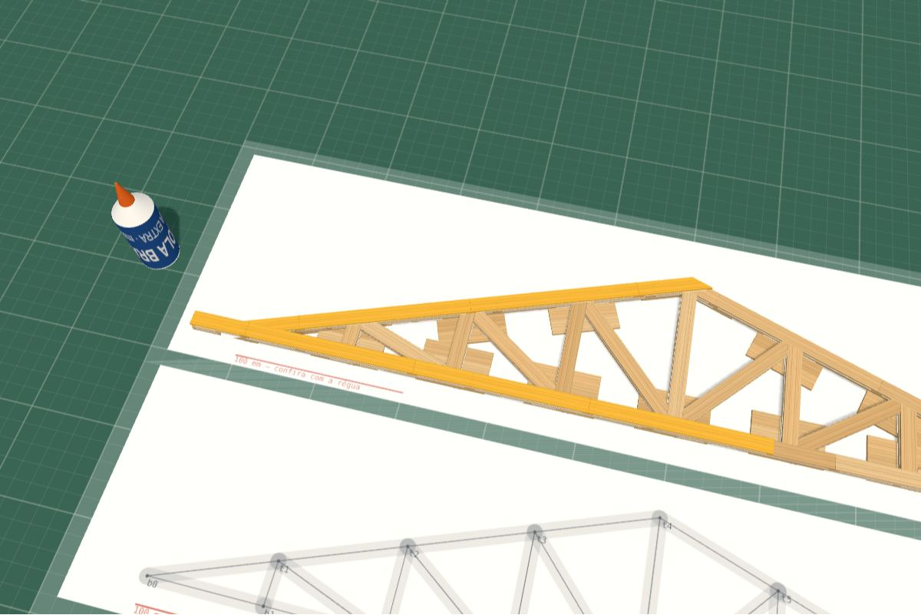
docs/img/manual/p18.jpg
