fernandobeckman/ponte-de-palito-/docs/img/manual/p19.jpg

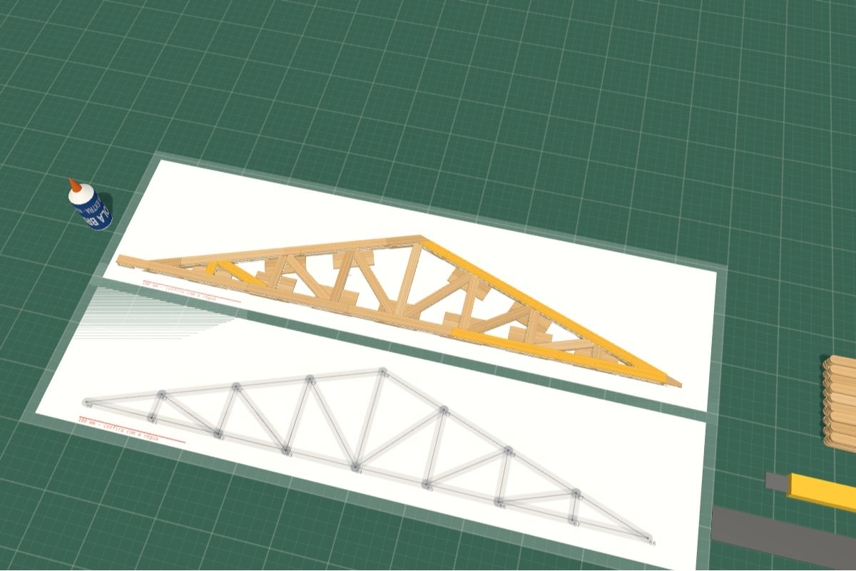
docs/img/manual/p19.jpg
