fernandobeckman/ponte-de-palito-/docs/img/manual/p20.jpg

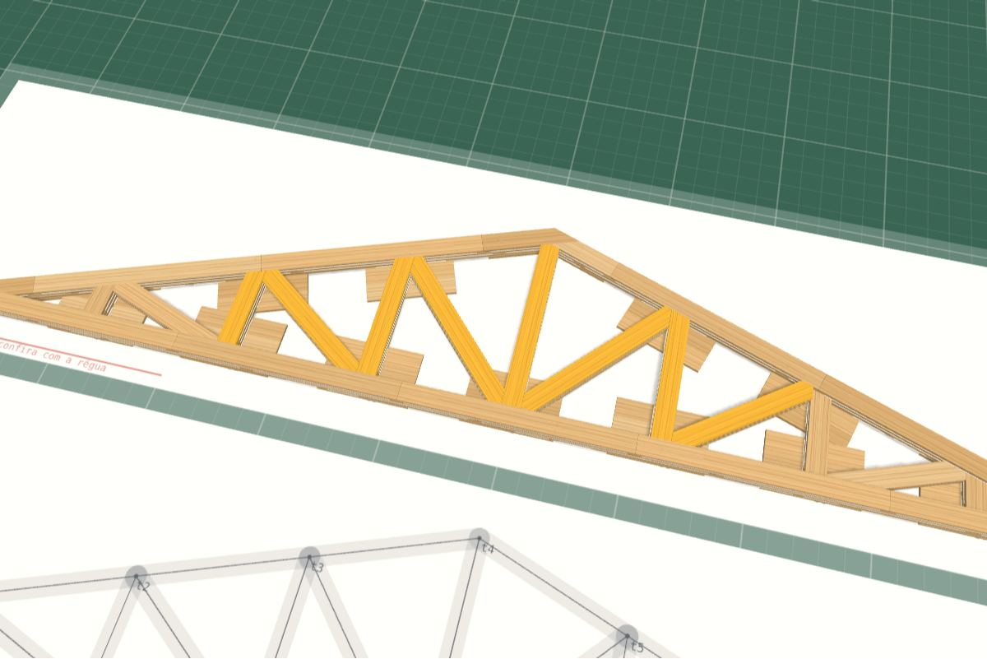
docs/img/manual/p20.jpg
