fernandobeckman/ponte-de-palito-/docs/img/manual/p23.jpg

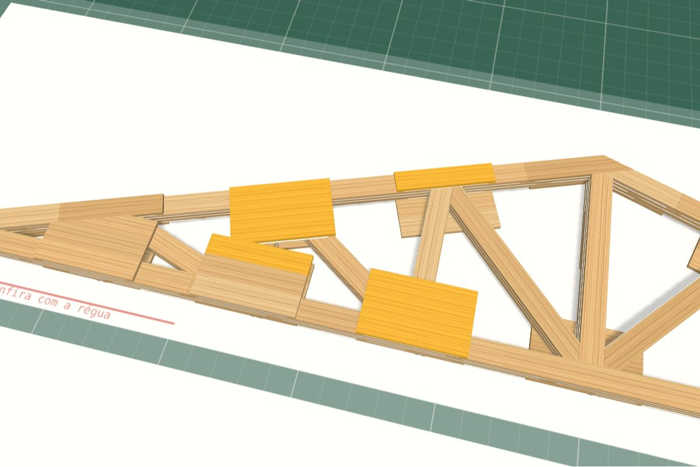
docs/img/manual/p23.jpg
