fernandobeckman/ponte-de-palito-/docs/img/manual/p24.jpg

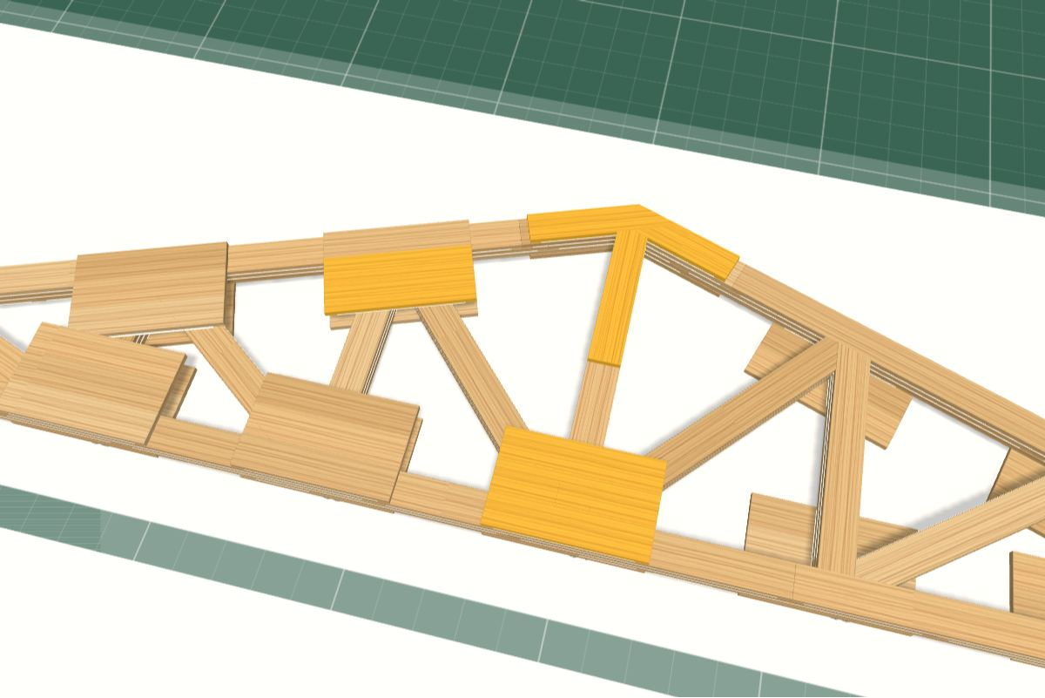
docs/img/manual/p24.jpg
