fernandobeckman/ponte-de-palito-/docs/img/manual/p25.jpg

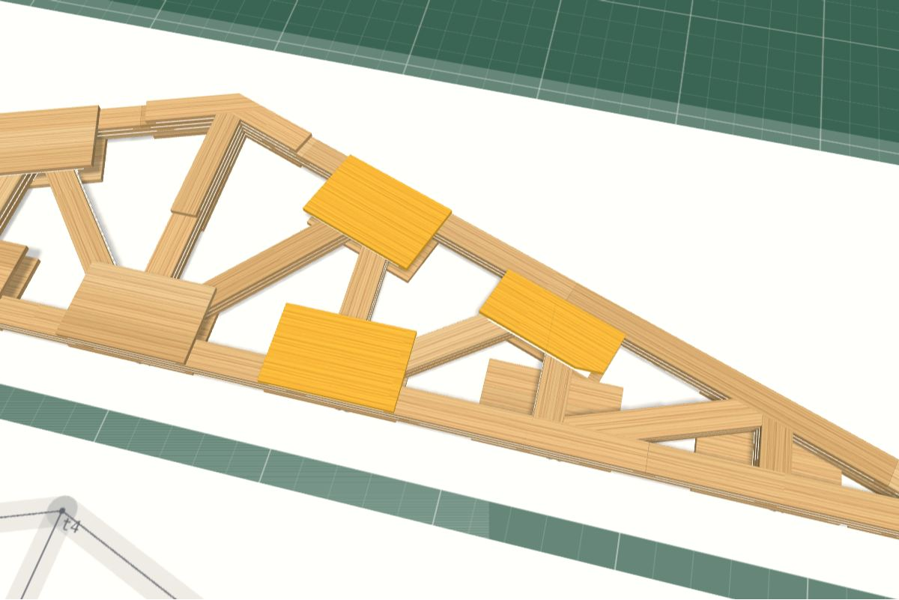
docs/img/manual/p25.jpg
