fernandobeckman/ponte-de-palito-/docs/img/manual/p26.jpg

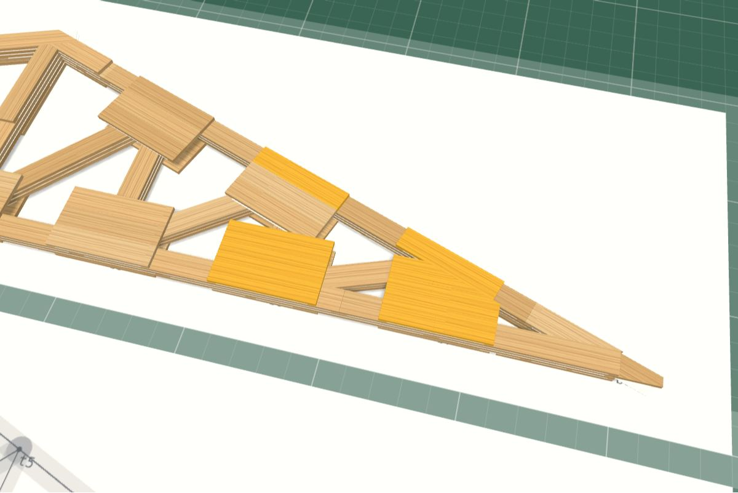
docs/img/manual/p26.jpg
