fernandobeckman/ponte-de-palito-/docs/img/manual/p27.jpg

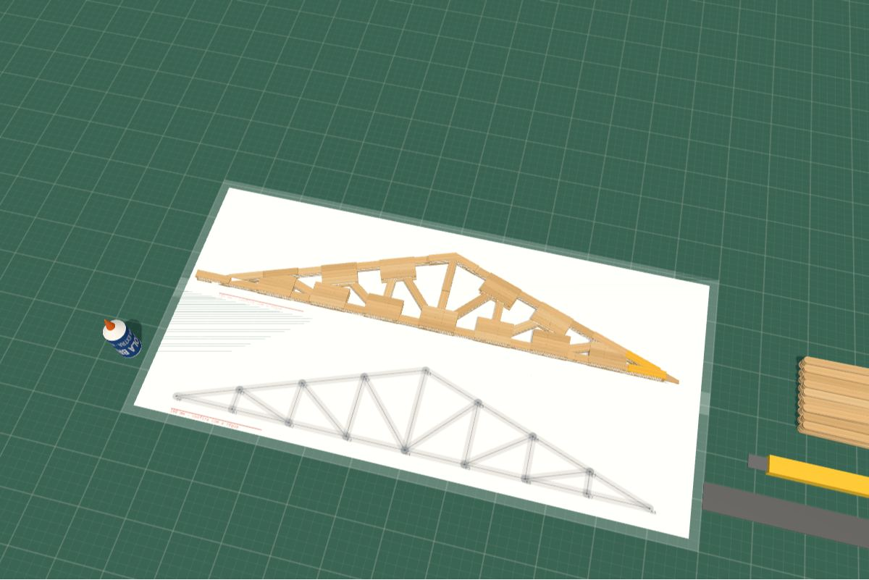
docs/img/manual/p27.jpg
