fernandobeckman/ponte-de-palito-/docs/img/manual/p28.jpg

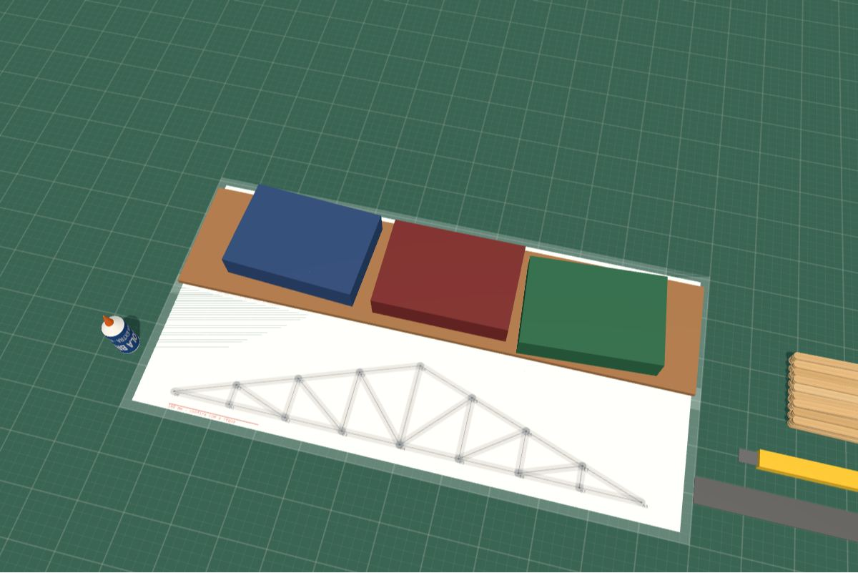
docs/img/manual/p28.jpg
