fernandobeckman/ponte-de-palito-/docs/img/manual/p31.jpg

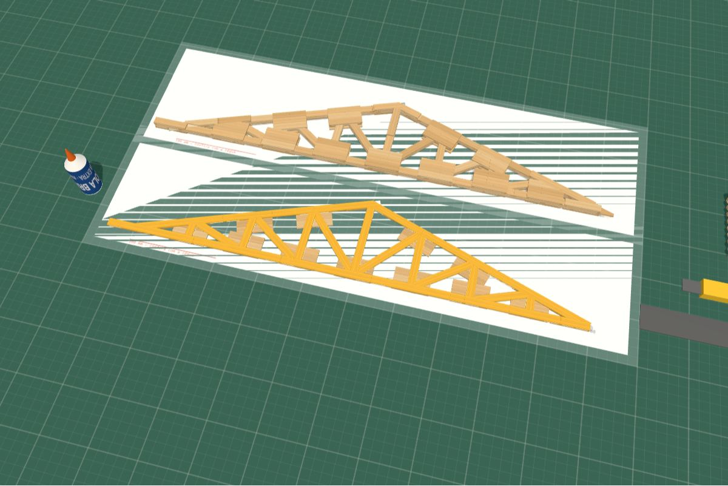
docs/img/manual/p31.jpg
