fernandobeckman/ponte-de-palito-/docs/img/manual/p32.jpg

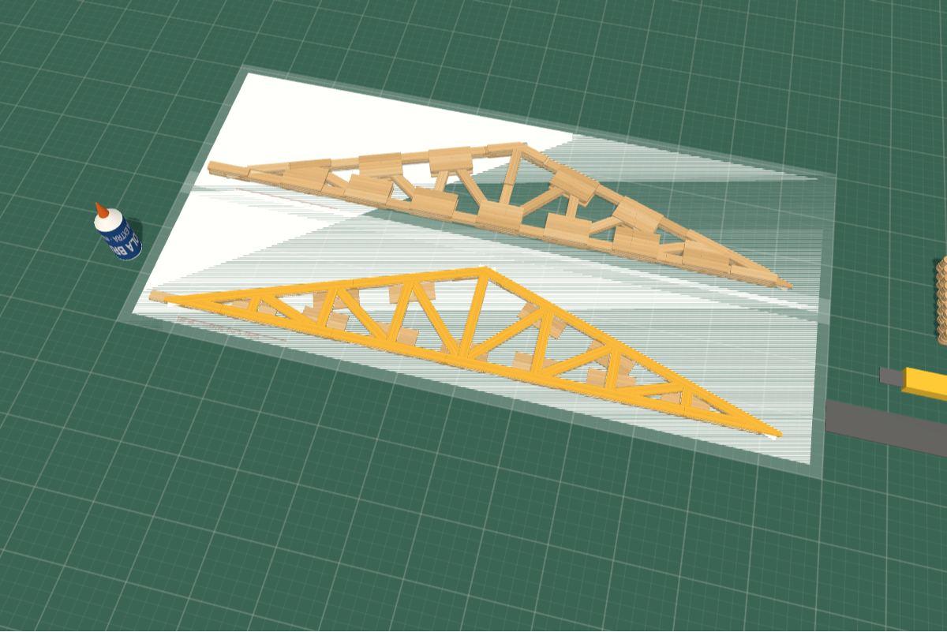
docs/img/manual/p32.jpg
