fernandobeckman/ponte-de-palito-/docs/img/manual/p33.jpg

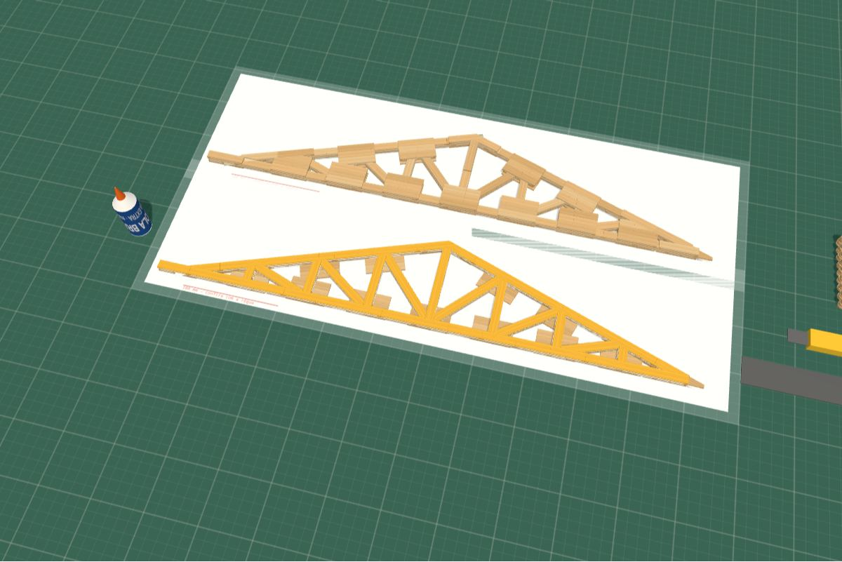
docs/img/manual/p33.jpg
