fernandobeckman/ponte-de-palito-/docs/img/manual/p34.jpg

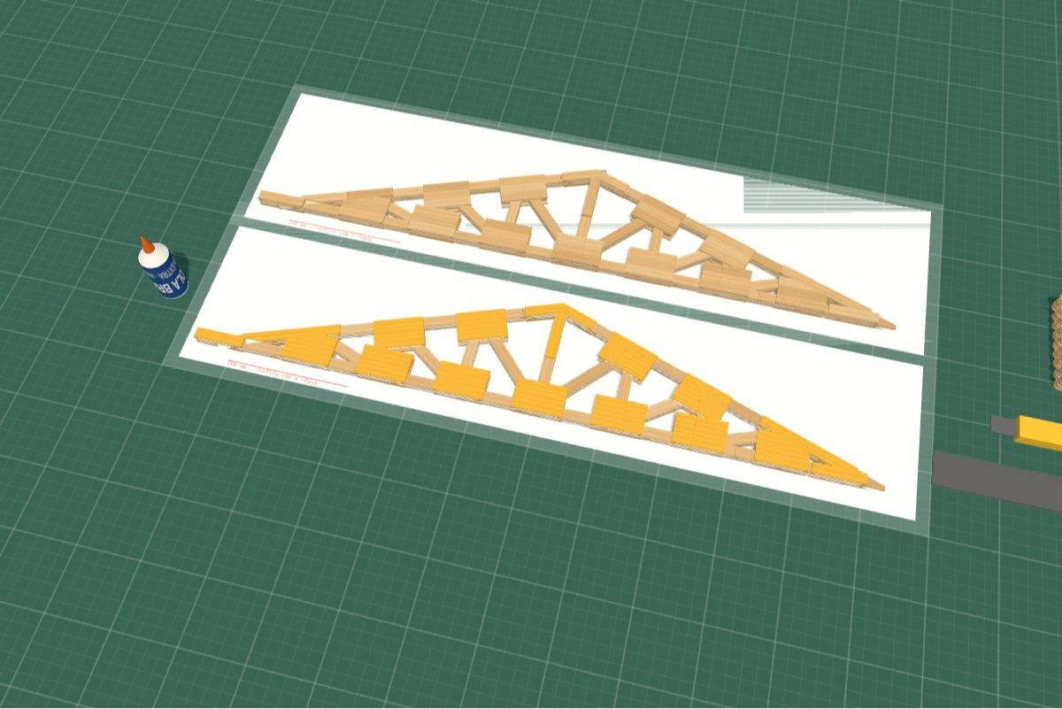
docs/img/manual/p34.jpg
