fernandobeckman/ponte-de-palito-/docs/img/manual/p35.jpg

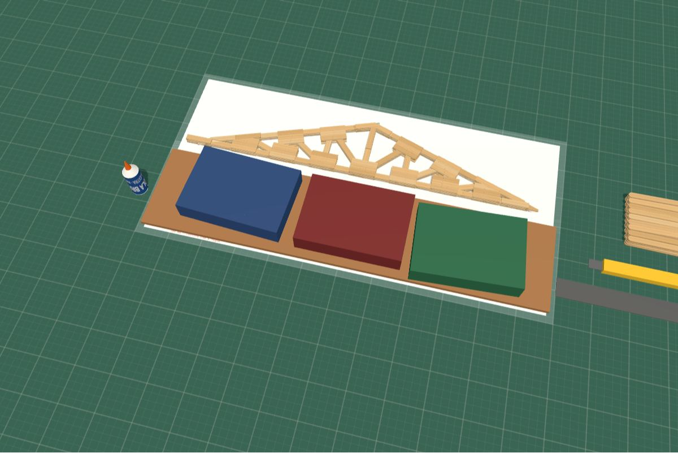
docs/img/manual/p35.jpg
