fernandobeckman/ponte-de-palito-/docs/img/manual/p38.jpg

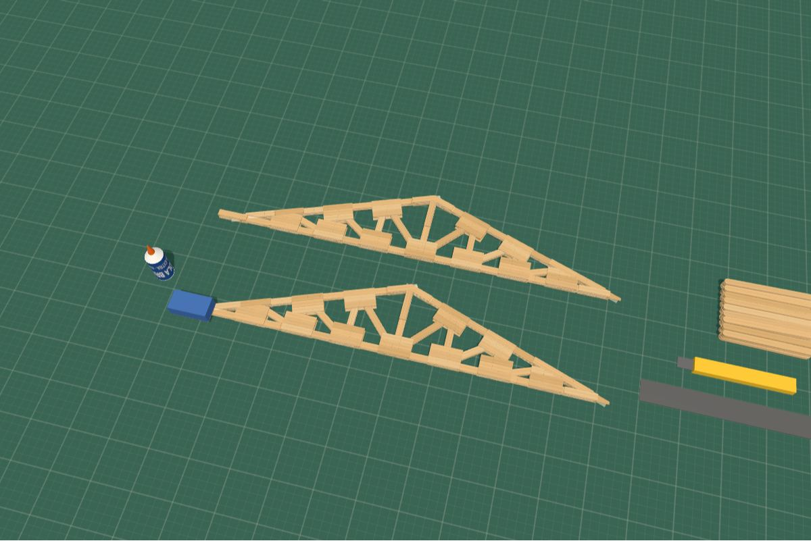
docs/img/manual/p38.jpg
