fernandobeckman/ponte-de-palito-/docs/img/manual/p39.jpg

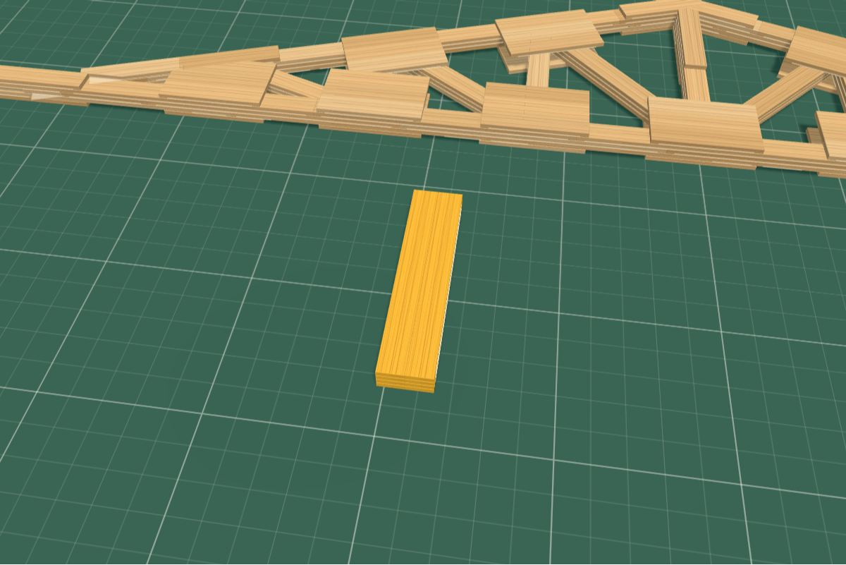
docs/img/manual/p39.jpg
