fernandobeckman/ponte-de-palito-/docs/img/manual/p40.jpg

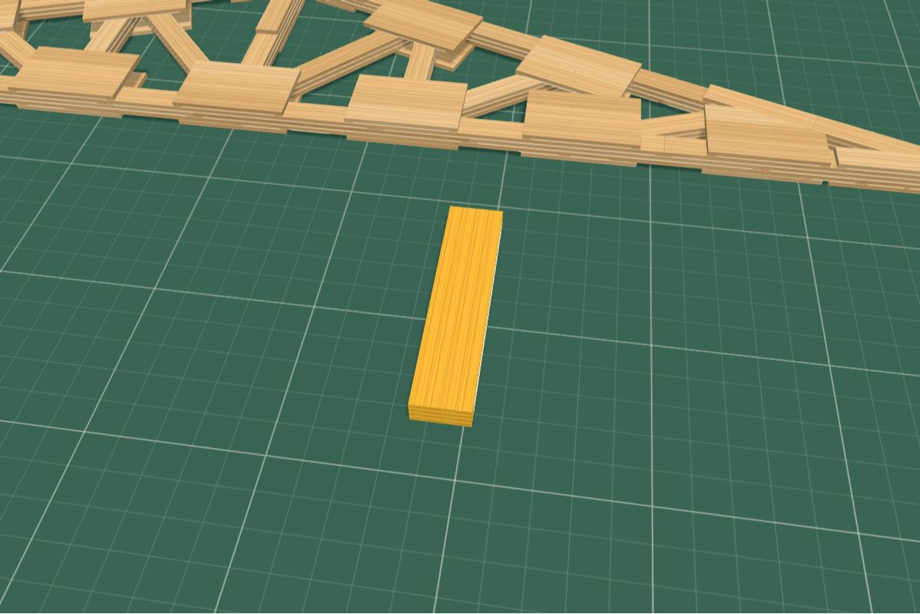
docs/img/manual/p40.jpg
