fernandobeckman/ponte-de-palito-/docs/img/manual/p42.jpg

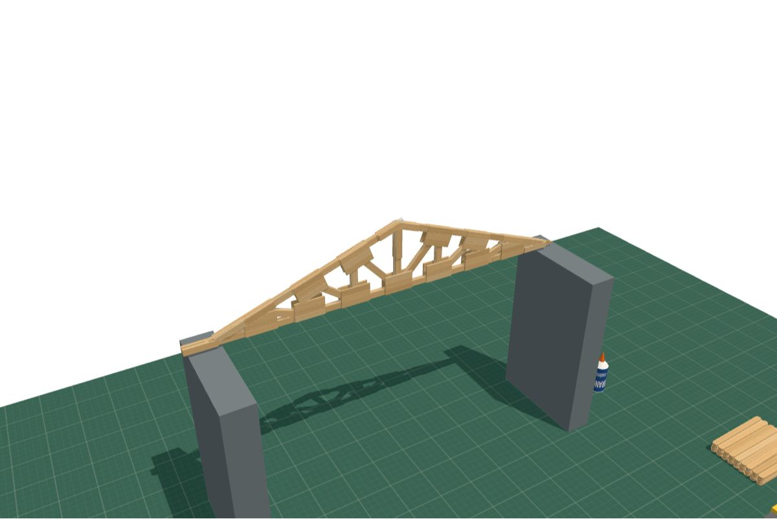
docs/img/manual/p42.jpg
