fernandobeckman/ponte-de-palito-/docs/img/manual/p45.jpg

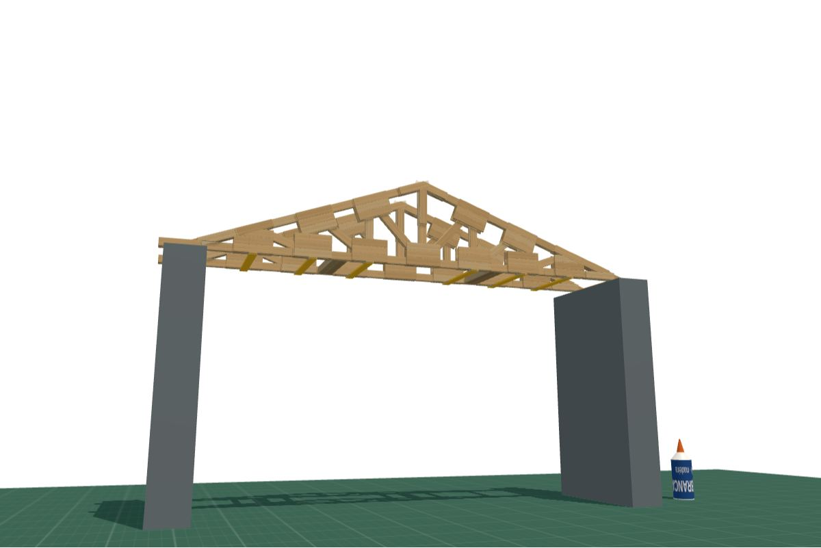
docs/img/manual/p45.jpg
