fernandobeckman/ponte-de-palito-/docs/img/manual/p47.jpg

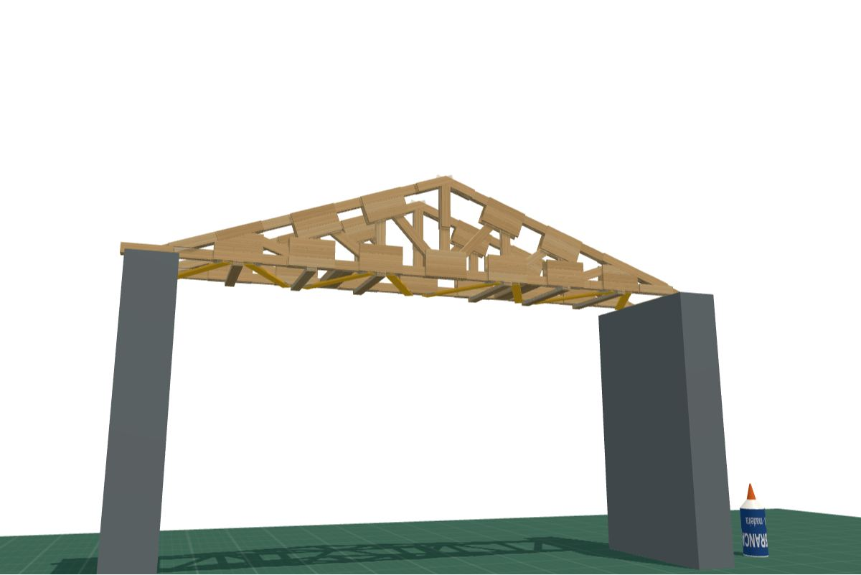
docs/img/manual/p47.jpg
