fernandobeckman/ponte-de-palito-/docs/img/manual/p48.jpg

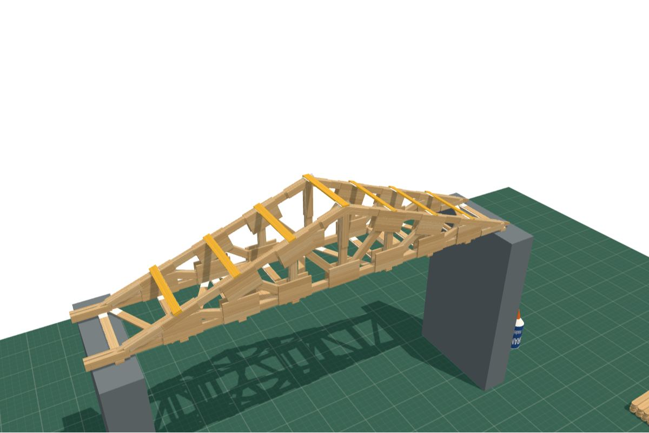
docs/img/manual/p48.jpg
