fernandobeckman/ponte-de-palito-/docs/img/manual/p49.jpg

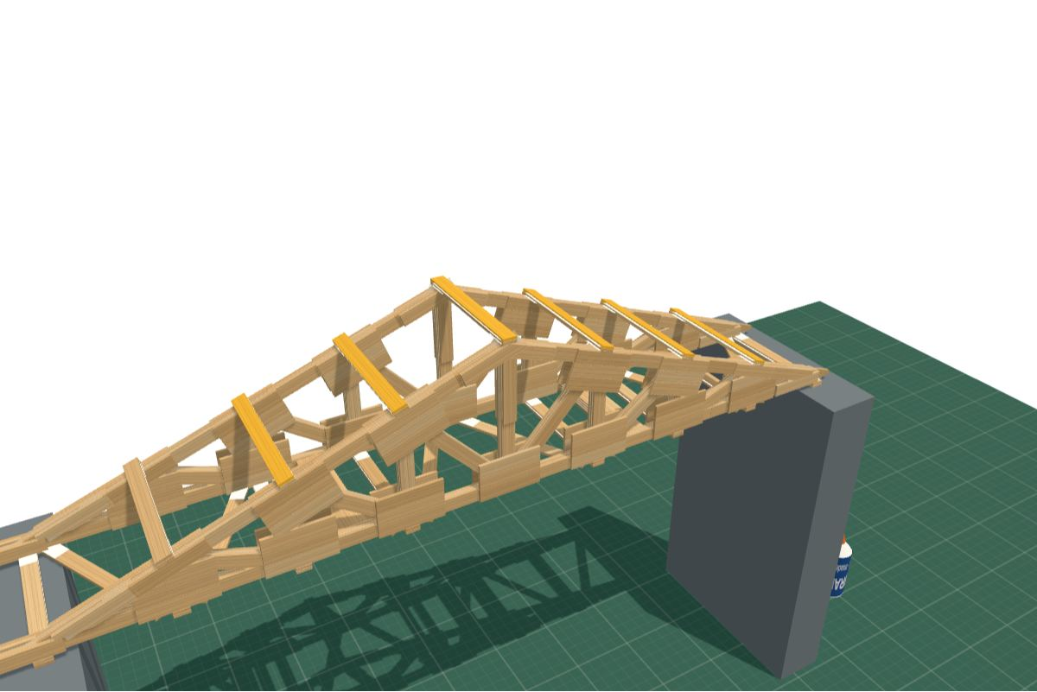
docs/img/manual/p49.jpg
