fernandobeckman/ponte-de-palito-/docs/img/manual/p50.jpg

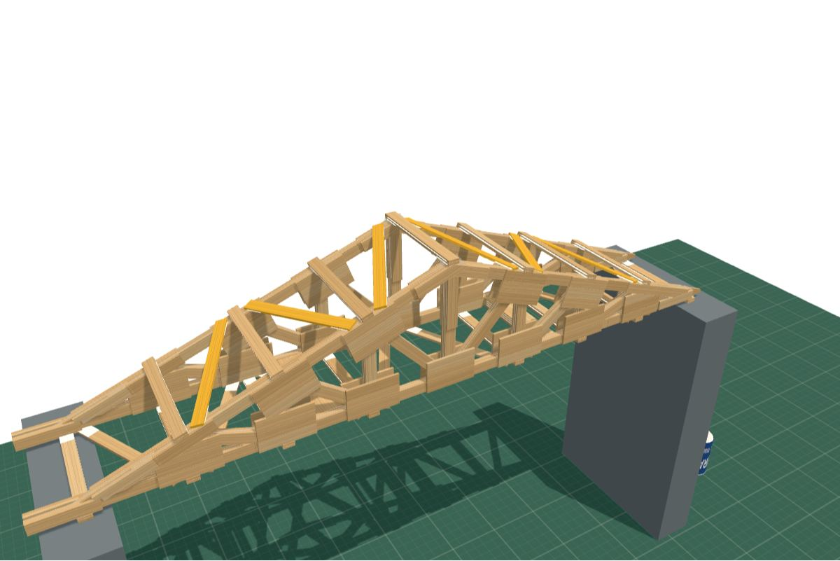
docs/img/manual/p50.jpg
