fernandobeckman/ponte-de-palito-/docs/img/manual/p51.jpg

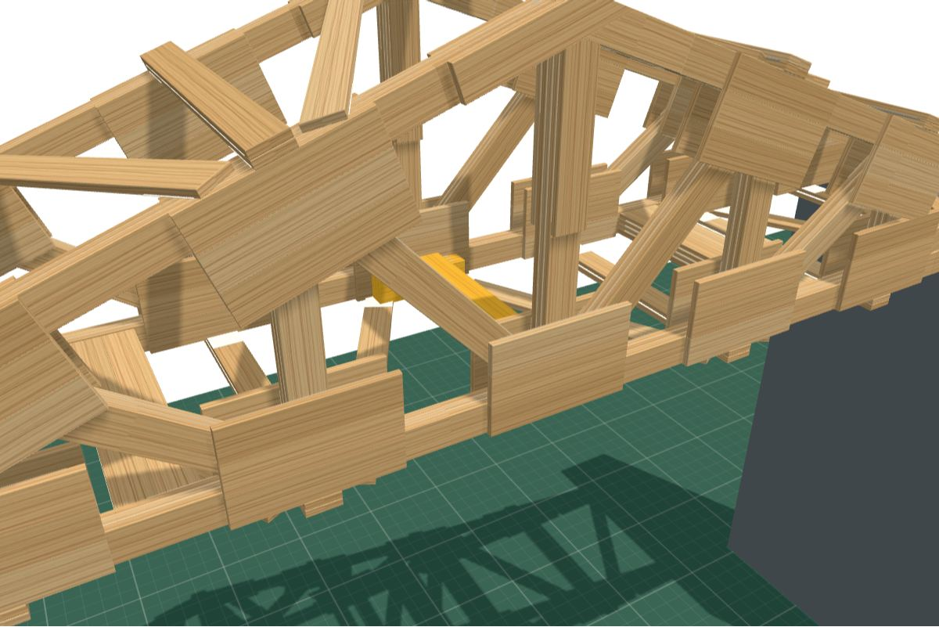
docs/img/manual/p51.jpg
