fernandobeckman/ponte-de-palito-/docs/img/manual/p52.jpg

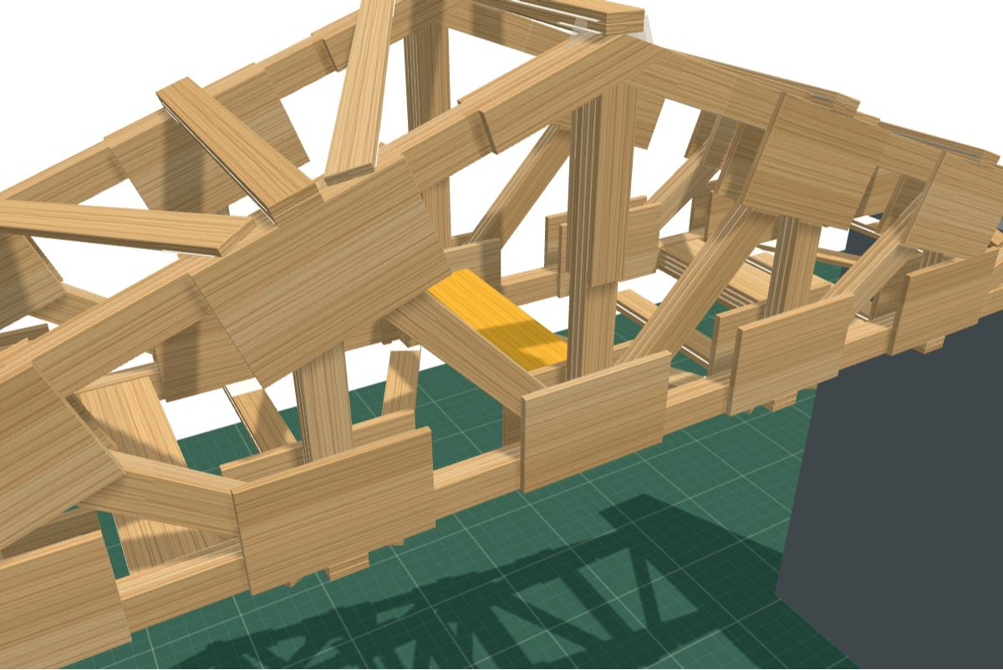
docs/img/manual/p52.jpg
