fernandobeckman/ponte-de-palito-/docs/img/manual/p53.jpg

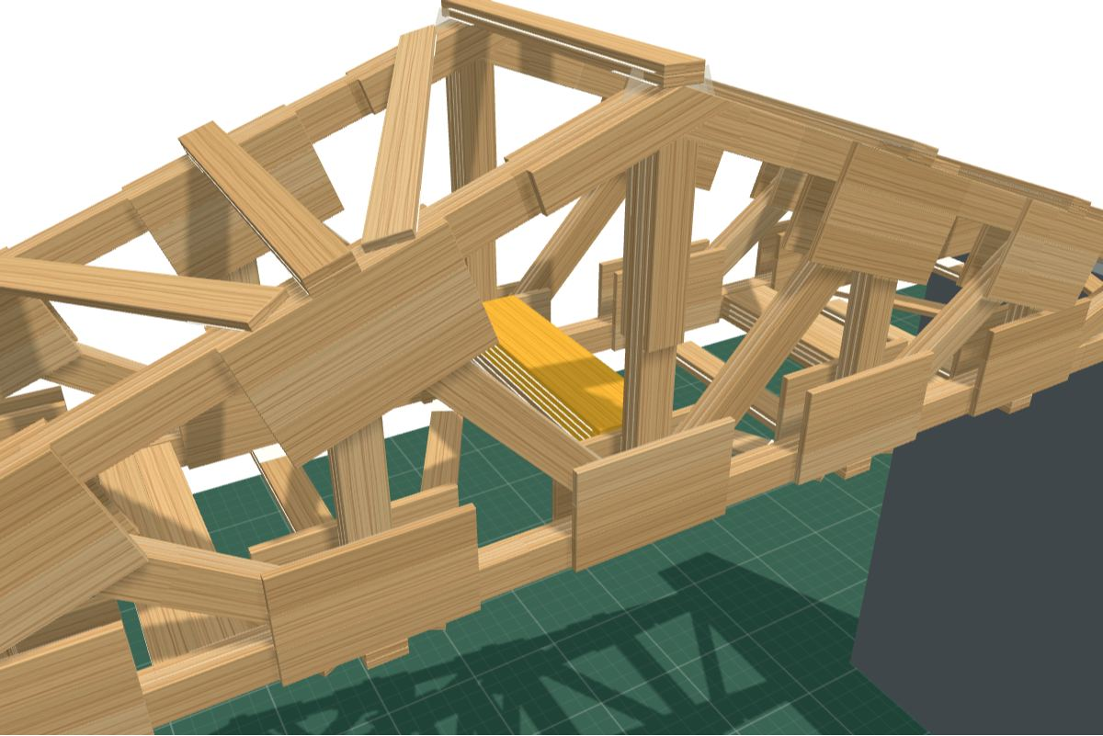
docs/img/manual/p53.jpg
