fernandobeckman/ponte-de-palito-/docs/img/manual/p54.jpg

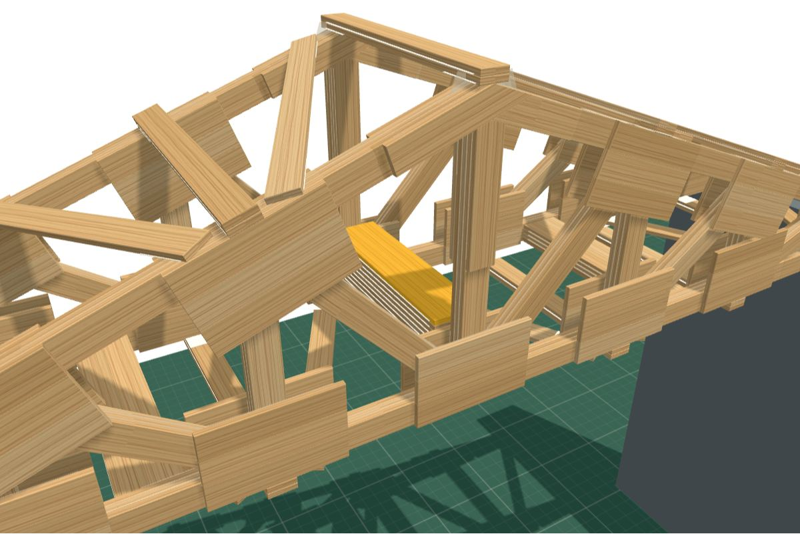
docs/img/manual/p54.jpg
