fernandobeckman/ponte-de-palito-/docs/img/manual/p58.jpg

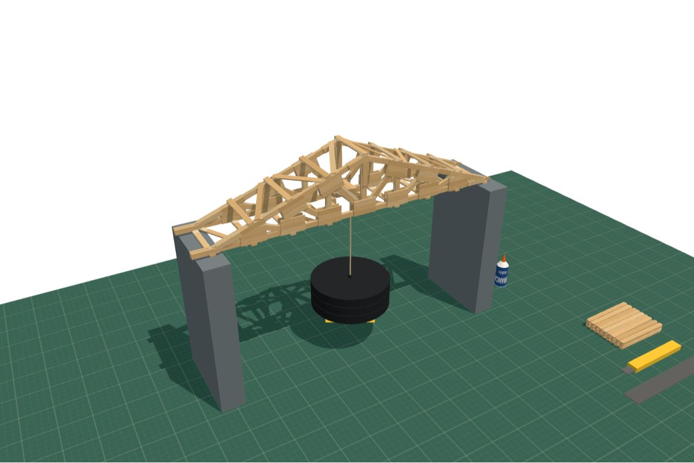
docs/img/manual/p58.jpg
