fernandobeckman/ponte-de-palito-/(commit log)

2026-11-09 Adiciona 83 agentes e 76 skills para engenharia de pontes, 3D e sites
    - 69 agentes VoltAgent (MIT) + 14 agentes próprios de engenharia estrutural
    - 13 skills Anthropic (Apache-2.0), 29 wshobson (MIT), 24 Three.js OpenAEC (MIT)
    - 10 skills próprias: solver de treliça testado, flambagem, CAD, 3D web, ensaio, relatório
    - CLAUDE.md, ERROS.md (registro de erros) e catálogo com fontes e licenças
    Claude-Session: https://claude.ai/code/session_01BtvtDiiZppKhog5pohq5Bb
2026-11-09 Registra erro de referência remota em clone raso
    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
2026-11-09 Projeto e cálculo estrutural da ponte Parker 8 painéis (45 kg, vão 500 mm)
    - Estudo comparativo de 208 geometrias (Pratt, Howe, Warren, Parker)
    - Cálculo completo com envoltória de carga, flambagem, ligações e transversina
    - Memorial, gabarito 1:1, modelo 3D (Three.js) e OpenSCAD
    - Solver de treliça com precisão de 5 casas; ERROS.md atualizado
    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
    [ponte_parker_8x90.scad]
2026-11-09 Remove arquivos .pyc do controle de versão
    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
2026-11-09 Registra erro de fluxo git no ERROS.md
    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
2026-11-09 Adiciona página do projeto para celular (3D, esforços, montagem)
    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
2026-11-09 Montagem animada palito por palito, orçamento e memorial v2
    - Modelo físico com 404 peças, ordem de montagem, lista de corte e cola
    - Página 3D com arrasto, 360°, corte, cola, prensagem, cura e ensaio
    - Orçamento com preços editáveis e fontes
    - Memorial v2: alma com 3 camadas, chapas com 2 faixas, transversina em consolos
    - ERROS.md: entradas 16 a 21
    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
2026-11-09 Corrige 3D no celular: sem import map, controles próprios e modo texto
    - Three.js importado pelo endereço completo (jsDelivr, com unpkg de reserva)
    - Controle de órbita próprio (arrastar, pinça, roda do mouse, giro 360°)
    - Se o 3D falhar, os passos continuam funcionando em texto
    - ERROS.md: entrada 22
    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
2026-11-09 Espaçadores provisórios: 74 mm, fora das chapas e com visual de peça temporária
    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
2026-11-09 Espaçadores provisórios feitos de palito e requisitos do projeto
    - Espaçadores: 2 blocos de 4 camadas x 2 palitos de 74 mm, montados palito por palito na animação
    - Orçamento: +16 palitos (368 a comprar)
    - docs/requisitos.md com as regras da equipe (só palito e cola branca)
    - ERROS.md: entrada 24
    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
2026-11-09 Manual de peças estilo LEGO: numeração, códigos, ângulos de corte e moldes 1:1
    - Cada peça numerada (1 a 412) e cada formato com código (37 tipos)
    - Comprimento, bordas e ângulos calculados da geometria exata
    - 3D: números sobre as peças, cores por família, destaque por código
    - Legenda do passo com o desenho da peça e as medidas de corte
    - Cartões do manual e lista numerada na página
    - PDF com moldes em tamanho real e índice numerado (projeto/manual)
    - Peças encostam de topo sem folga; chapas menores que 80 mm² removidas
    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
2026-11-09 ERROS.md: entrada 26 (medidas do manual de corte)
    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
2026-11-09 Site público para GitHub Pages (pasta docs/)
    - Página inicial para família e amigos, com imagens, como funciona, formato e montagem
    - Montagem 3D e cálculo como páginas completas, com menu
    - Manual de corte em PDF e gabarito para baixar
    - Prévia para WhatsApp (Open Graph) com imagem de capa
    - Geradores: projeto/gerar_site.py e projeto/renderizar_imagens.js
    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
2026-11-09 Atualiza site/montagem.html gerado (gancho de foco da câmera)
    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
2026-11-09 Configuração da Netlify (publica docs/) e prévia apontando para ponte-de-palito.netlify.app
    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
2026-11-09 Script de publicação na Netlify e ERROS.md entrada 28
    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
2026-11-09 3D em tela cheia com botões e saída (botão Sair, Esc e voltar do celular)
    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
2026-11-09 Manual estilo LEGO (em andamento): plano de passos, scripts, link direto para passo no 3D
    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
2026-11-09 Aba Manual estilo LEGO: 58 passos, 50 imagens, etiquetas tocáveis com o número de cada peça
    - Caixa 'peças deste passo' com desenho, código e quantidade (toque filtra as etiquetas)
    - Ficha da peça com medidas, ângulos e link para o passo no 3D
    - Marcação 'Feito' por passo com progresso
    - Etiquetas sobrepostas espalhadas com linha-guia
    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
